zx90316/Flip-Clock/cad/r2/README.md

# FC-R2 桌面翻頁鐘原型

狀態：本輪模擬定位通過，仍為 CAD／剛體接觸原型。顯示可讀性、逐片翻轉、列印配合、馬達、彈簧與長時間運轉尚待驗證。

本輪交付：[校準結果與限制](RESULTS.md)、[STEP／STL 原型包](package/FC-R2-desktop-prototype.zip)、[正面物理回放](review_native/front.mp4)、[機構剖視](review_native/cutaway.mp4)。本輪修正實體棘爪止擋，改用原生碰撞演算法，並提高小時輪的被動阻力；驗收以逐步紀錄及時間步長比較為準。舊版未通過的運算保留在 `review/`。

[本機 3D 檢視與逐件目錄](VIEWER.md) 提供裝配、機構、試片與 141 個列印件的連結，可自行開啟查看。

## 桌面尺寸與外觀

外形 190 × 175.4 × 120 mm（深度包含前框），底板 190 × 174 mm。相較 R1 的 312 × 280 mm 底板，占桌面積減少約 62%。暖白圓角外殼、深色前板、雙視窗與白色冒號；前板從內側固定，傳動與調時旋鈕收在殼內。

外殼分成底板、倒置列印的罩殼、平放列印的前後板與前框。後蓋可拆，方便調整與校準。STEP 的扇形翻片是檢查姿態；實際重力姿態以模擬回放為準。

## 單馬達機構

- 分鐘 60 片，每格 6°；小時 24 片，每格 15°。
- 一顆馬達、兩組方向相反的實體棘爪；負向輸入驅動分鐘，正向輸入驅動小時。兩個輸出都向展示面下翻。
- 棘爪增加連通的尾端止擋面，載體使用避開樞軸的實體止擋；原生輪廓掃描在接合側約 3.5° 開始接觸，空轉側檢查至 35° 無干涉。這不是以關節角度限制代替接觸。
- 分鐘齒輪 40→20→40；小時 60→20→20→40。小時輸出速度為輸入的 1.5 倍，方向相反。
- 分鐘樞軸半徑 36.5 mm；小時 14.9 mm，小時軸向前移 21.6 mm。兩輪正面樞軸同在 Y=36.5 mm，相鄰下半頁的樞軸高度差約 0.04 mm。
- 每輪獨立定位凸輪、彈簧壓輪與最終輸出角度回授位置。
- 馬達經 1:1 皮帶傳到共用輸入軸。皮帶彈性、跳齒與齒輪箱內部間隙尚未模擬；馬達是有限扭矩等效模型。

50 mN·m 是模擬用輸入扭矩預算，不是已確認的 28BYJ-48 規格。實際馬達與驅動器尚待選型，不能直接把模擬扭矩命令當成現有韌體。

## FDM 設計

依使用者指定的 Bambu X2D、0.4 mm 噴嘴、0.2 mm 層高、256 × 256 mm 成形面設計。所有列印件在指定方向的 XY 尺寸均落在此範圍；未輸出機台 G-code。

翻片採 1.2 mm 完整薄片，等於六層 0.2 mm。實心轉軸保留 Ø2.2 mm 最大迴轉包絡，前緣削平到與片面共面，正面貼床；這能保留薄片間隙，又不讓大片片體懸空。軸孔名義 Ø2.6 mm，另附 Ø2.4／2.5／2.6／2.7 mm 試片供 PLA、PETG 各自調配。

字樣為自繪七段向量，採雙面轉印或模板上色，STL 沒有凸字與凹槽。這保留完整 1.2 mm 片厚。先用 M08、M09 試片確認正反面方向，再處理全部 84 片。[轉印稿](graphics/README.md)

機構受力件與翻片先按實心列印，以便對照模擬質量；外殼可依標準材料設定使用較低填充。建議先試 PETG 活動件與 PLA 外殼，兩種材料都要重新量測配合。切片時保留原有外形比例，不要整組縮放補孔。

罩殼外頂面貼床、側壁向上生長；前後板平放；齒輪、棘爪、凸輪與側架以寬面貼床。部分軸筒上肩、底部孔口與內側固定耳需要局部支撐／橋接驗證，外觀表面不應接觸支撐。擋線定位孔需鑽修至 Ø1.1 mm。完整量測見 [FDM 報告](reports/dfam/summary.json)，不能把壁厚通過解讀為已完成切片與列印驗證。

## 檢視與重建

- `STEP/assembly.step`：包覆外殼的檢查姿態。
- `STEP/assembly_with_drag.step`：加入兩個非列印毛氈阻力環的候選裝配；其餘列印件相同。
- `STEP/mechanism.step`：機構檢查姿態。
- `STL/coupons.stl`：薄片、轉軸孔與 Ø8 mm 軸孔試片。
- `STL/parts/`：按指定方向落床的零件。以 `reports/parts.json` 為有效清單，目錄中其他舊輸出不屬於交付。
- `review_native/`：本輪選定的原生碰撞求解紀錄、影片、逐步驗收與來源雜湊。
- `review/`：保留的舊版失敗紀錄；原始試驗在忽略版控的 `runs/`。

從專案根目錄執行 `cad/r2/build.ps1 -Fdm -Physics`。需要已安裝 text-to-cad 0.7.17 與 uv；套件版本記錄在 `reports/dependencies.lock.json`。此流程不開啟桌面視窗，也不連線列印機。

原型 ZIP 保留 `Flip-Clock/cad/r2` 與所需共用函式的目錄結構；解壓後在 `Flip-Clock` 執行同一指令。DfAM 工具預設從使用者的 text-to-cad 0.7.17 安裝尋找，若位置不同可用 `DFAM_SKILL_DIR` 指向 `dfam-check` 資料夾。影片與完整碰撞求解資產另存 GitHub 的 `review_native/`，沒有塞入列印原型 ZIP。

## 分／時輪阻力候選

本輪候選為分鐘 5 mN·m、小時 20 mN·m 的庫侖阻力，設定見 [drag_candidate.json](config/drag_candidate.json)。舊版的 15 mN·m 小時阻力在原生碰撞計算下雖能連續到位，閒置瞬間偏移仍曾超過 0.25°，因此提高小時輪阻力重測。這是力等效參數整定，尚未量到真實材料的阻力。

候選機構在既有軸承外側與調時旋鈕間，加入外徑 20 mm、內徑 16.2 mm、安裝厚度 1.1 mm 的非列印毛氈環。名義尺寸在 STEP 中無實體重疊；不能據此推定預壓、磨耗與阻力已成立。以旋鈕半徑 13 mm 量測時，先抬起定位壓輪，分鐘／小時的切向阻力目標分別約 0.385／1.538 N。實際環厚與預壓需依量測調整。

這兩個環在目前剛體模型中只由 `dof_frictionloss` 作力等效，沒有解析毛氈壓縮接觸。單獨開啟 XML 不會自動套用候選值；完整參數在 `review_native/run_config.json`，重建指令會套用設定檔。

本輪另以 [原生碰撞與摩擦求解設定](config/native_friction_trial.json) 降低靜止摩擦的數值滑動：接觸時間常數仍為 0.0006 s，關節摩擦時間常數改為 0.0002 s、阻抗 0.999。這些是求解器的正則化設定，不是 PETG 彈性或毛氈的實測材料數據。`build.ps1 -Physics` 會套用此檔並檢查每個步進；兩種時間步長及額外連續測試的固定證據保存在 `review_native/`。

## 模擬證據的範圍

MuJoCo 3.17.0、真實重力、由原生 CAD 輪廓生成的凸分塊碰撞、84 個獨立翻片鉸鏈。只有輸入軸施加有限扭矩；沒有理想齒輪關係、單向關節或指定輸出角度。定位彈簧與軸阻力使用明列的力等效假設。

從初始翻片與齒隙狀態起，每一次指令都納入驗收，包含第一循環。目標沿名義刻度前進，失步後不把目標改設到錯誤的實際位置。閒置輪檢查每個積分步的瞬間偏移，並以最後一次命令刻度為基準；另檢查停靠最後 0.25 秒的振幅與速度。`COMPLETED` 僅表示運算結束，驗收以 `validation.json` 及時間步長比較為準。

底座固定於世界座標，未測整機滑移或傾倒。質量來自完整 CAD 體積與提案密度，尚未秤重；齒輪與軸的同體連接假設剛性傳力，實物固定方式與配合仍需驗證。沒有模擬薄片彎曲、列印層間強度、孔磨耗、感測器誤差與電子延遲。可視網格保留完整外形；碰撞中填平非工作減重孔、字樣與部分固定孔，軸承與軸銷內部用鉸鏈等效。實機、壽命與製造就緒旗標均維持 false。

## 來源

本輪由專案自建的 R1 基礎函式重新參數化，未把原作者 ZIP 或其網格作為幾何輸入。字形與外殼均為新建。標準軸承使用名義包絡；STEP 零件庫查詢紀錄在 `reports/catalog_search.json`，馬達與皮帶尚未完成採購尺寸確認。

FDM 限值依 text-to-cad 0.7.17 的 dfam-check 預設（支撐壁厚 1.2 mm、懸空壁厚 1.6 mm、45° 支撐角）比較。列印方向與配合仍應以機台試片校準；可參考 [Prusa 的列印設計說明](https://help.prusa3d.com/article/modeling-with-3d-printing-in-mind_164135)。彈簧力率提案使用圓線螺旋彈簧關係式，並非實測，公式可對照 [Maruho Spring 設計資料](https://www.maruho-htj.co.jp/en/mnet/design/compression/)。
