zx90316/Flip-Clock/cad/r2/graphics/README.md

# FC-R2 雙面字樣轉印稿

四張 A4 SVG、100% 尺寸；每格 34 × 18 mm。H00–H23、M00–M59。

正面是本片的上半字，背面是下一片號碼的下半字。背面圖樣配合繞 X 軸翻轉，刻意鏡像；請依檔案直接製作，不要再次鏡像。正反面分開轉印／遮罩上色；本稿未宣稱印表機雙面套準。先用 M08 與 M09 兩片確認翻轉後讀值，再處理整組。

字樣為本專案自繪七段向量，不使用原作者圖樣或外部字型。這是上色／轉印圖樣，STL 保持完整 1.2 mm 薄片，不含凸字或刻槽。不同塗層厚度與磨擦必須實際驗證。
