zx90316/Flip-Clock/cad/source/original/README.md

# 原作者資料（本機封存）

本資料夾保存使用者提供的 `Flip+Clock+Mechanism.zip` 及解開的模型。
原檔不修改、不執行，也不納入 Git 或公開發布。來源為 MakerWorld 908946，
作者 NotKuro。來源授權目前依使用者規格書記載為 Standard Digital File License；
本機 ZIP 沒有提供完整授權文字，不能據此授權再散布。

接收、檔案清單及 SHA-256 見 `../../reports/original_manifest.json`。
網格座標量測不代表實物配合已驗證；缺少組裝 PDF／原生 CAD 的項目保留待確認。
