zx90316/Flip-Clock/cad/DESIGN.md

# FC-R1 設計依據與組裝

設計決策 2026-11-04：依使用者「完整重新設計」指示，取代 908946 轉接／沿用方案。
本設計自行選定尺寸、輪廓與裝配方式。先前已讀取原 ZIP 清單、網格包圍盒和部分縮圖；
切換後的建模來源不引用該資料。不聲稱未接觸過原檔。

## 功能與座標

[R] 一顆馬達、無換檔致動器；以輸入正反轉選擇兩組相反接合的超越式棘輪。
時輪 24 片 00–23，分輪 60 片 00–59；兩輪各有定位、手動順向校時與最終輸出感測。

X 沿平行轉軸，Y 向顯示正面，Z 向上。所有轉角依同一 +X 右手法則。
共同輸入 I 在 Y=-108 mm，鼓軸在 Y=0，兩者 Z=88 mm。
時／分鼓中心 X=+42／-42 mm；齒輪工作平面 X=+76／-76 mm。
從 +Y 看向時鐘正面時，+X 在畫面左側，因此時輪在左、分輪在右；字形亦按此方向配置。
這些尺寸全部是 [P] 新設計起點，不是原機量測或列印配合保證。

分支兩次外嚙合：(+I) → (+OM) → (−idler) → (+M)，40:20:40，rM=1。
時支一次外嚙合：(−I) → (−OH) → (+H)，60:60，rH=1。
M+ 或 H+ 手動超越的可行性須由實體棘爪、摩擦與定位接觸驗證；方向表不代替動態。
36 齒棘輪的單齒距為 10°，不是分輪 6° 的補步常數，因此必須使用最終輸出回授。

## 原創幾何

- 外齒輪由標準漸開線方程求得齒側，24 點樣條、實圓齒頂、實圓齒根及 0.25m 原生圓角。
- 內棘輪採圓整驅動面／越齒斜面，24／36／48 齒均有完整工作輪廓。
- 棘爪獨立樞轉，載體有實體止擋；金屬彈簧負責回位，不能用彈簧代替驅動面承載。
- 鼓盤為 51 mm 外半徑、48 mm 片軸半徑；內框、輪轂、減重孔、孔位完全另建。
- 翻片寬 48、長 26、厚 0.95 mm；鉸鏈桶外徑 4 mm、孔徑 2.3 mm，搭配 2 mm 銷。
- 數字不用作者字形、圖片或外部字型，使用專案自行定義的七段幾何。
- 每片 k 的上半為 k，下半背面為 (k+1) mod N；實際正面配對仍須落片驗證。
- 編號 k 的片軸方位為 −k×格距，確保輸出依 +X 正轉時，下一個編號會接近固定釋放方位。

## 支承與自由度

I 由兩端 608ZZ 支承，兩個棘爪載體固定在 I 上。每個輸出環有自己的滑動軸套，
不固定到框架，也不與另一輸出環夾死。OM、OH 相對 I 各保留旋轉自由度。
各棘爪有獨立銷及止擋；翻片各有獨立銷。

時、分鼓使用兩支獨立 Ø8 mm 軸，X 範圍分別 [4,116]、[-116,-4] mm，端部間隙 8 mm。
中央支架有兩個分離軸承座；外側各一個座。沒有共用剛性輸出軸。
分支惰輪以固定銷與獨立軸套支承在側架，齒輪不是懸浮示意件。
定位盤及旋鈕均在最終輸出軸上，位於離合器和傳動之後。
齒輪平面在 |X|=76 mm、定位盤在 |X|=87 mm，手動旋鈕在外框之外的 |X|=108 mm。
定位滾輪臂與彈簧設於齒輪外側；支架腳位及螺絲通道避免與側架底座交疊。
定位槽頂／底均有 0.4 mm 原生圓角。滾輪安裝位置依完整槽邊輪廓求最短距離，
幾何檢查姿態另留約 0.02 mm 間隙；不將此位置當成彈簧預壓下的動態平衡解。

## 起始製程與配合

[P] 框架、齒輪及鼓盤先以 PETG／PLA 試片比較；棘爪、鉸鏈與長期受力支架優先 PETG。
不提供虛構的材料強度或彈簧剛度。質量資料使用實心 CAD 估算，正式版本需秤重修正。

[P] 0.2 mm 層高、0.4 mm 噴嘴、4 壁、齒輪／棘爪 100% 填充起測；
配合階梯涵蓋 8 mm 軸單邊 0.15／0.20／0.25／0.30 mm 間隙。
齒輪與鼓盤平放，片體大面平放；片軸孔須清孔／鉸孔，不能把支撐殘痕當軸承面。
0.95 mm 翻片、0.85 mm 鉸鏈孔壁、棘爪齒根均需試印與受力驗證。

新支架為寬鬆台架尺寸，底板 312×280×6 mm，分成四塊，最大 168×140 mm。
接縫以四片上方連接板及 M3 螺絲固定；底部 TPU 腳墊提供 2 mm 空間。
實際成形面仍須逐件核對 STL 目錄的包圍盒，不把模型有效直接當成可量產證據。

## 建議裝入順序

1. 先印配合階梯、單離合器與鉸鏈試片，量測阻力與孔徑。
2. 從底板下側裝 M3 螺帽，上側裝側架、中央雙軸承座、馬達座與感測座；螺絲自上方進入。
3. 將六個 608ZZ 軸承裝入支架。中央兩座分開，確認軸承內圈不被端面夾緊。
4. 先在輸入軸套上兩組滑動軸套、輸出環、載體、棘爪銷與金屬彈簧，再穿入輸入軸。
5. 裝分支惰輪銷與軸套，確認工作平面及齒側間隙，再裝兩個最終輸出齒輪。
6. 分別裝鼓輪轂、左右鼓盤與 60／24 片翻片，穿銷，最後鎖固鼓盤及輪轂。
7. 裝兩支獨立輸出軸、定位盤、滾輪臂及預壓件，確認手動一圈不夾死。
8. 裝手動旋鈕、磁鐵帽、感測模組；釋放指先保持退開，再由單輪試驗逐步調整。
9. 完成感測零位校準、接觸／負載試驗後才裝護板，最後進行帶負載動作。

這是待實物確認的裝入順序。螺絲頭、工具通道、緊固長度、彈簧端部固定及軸承軸向擋件
仍須在製造凍結前逐項確認，不以裝配文字取代可拆裝驗收。

## 尚待取得的證據

- 棘爪的接觸相位、彈簧固定／預壓與自鎖／抬爪測試；金屬彈簧幾何不是剛度校準。
- 定位保持、手轉、馬達驅動同時成立的扭矩窗口，以及斷電回彈是否擾動另一輪。
- 翻片在重力下的堆疊、支承、單片釋放、落片及安全顯示角窗。
- 24／60 個位置的真實上下半頁配對與 23→00、59→00。
- 有限扭矩、摩擦、反轉背隙及完整接觸運轉的收斂／實測校準；已建立 MuJoCo 探索性檢視，見 PHYSICS_VIEW.md。
- 精確馬達軸扁位、編碼器模組／磁鐵規格、感測誤差與電氣接線。
- 靜強度、層間破壞、蠕變、磨耗與實機耐久；正式 BOM 的緊固件及擋圈完整選型。

正式製造包由驗證閘門封鎖。現有 ESP 韌體未修改，不當作新雙輸出閉迴路控制器。
