zx90316/Flip-Clock/tools/requirements-windows.lock.txt

bleak==3.0.1
winrt-runtime==4.0.3
winrt-Windows.Devices.Bluetooth==4!10.0.28000.2705
winrt-Windows.Devices.Bluetooth.Advertisement==4!10.0.28000.2705
winrt-Windows.Devices.Bluetooth.GenericAttributeProfile==4!10.0.28000.2705
winrt-Windows.Devices.Enumeration==4!10.0.28000.2705
winrt-Windows.Devices.Radios==4!10.0.28000.2705
winrt-Windows.Foundation==4!10.0.28000.2705
winrt-Windows.Foundation.Collections==4!10.0.28000.2705
winrt-Windows.Storage.Streams==4!10.0.28000.2705
typing_extensions==4.16.0
