zx90316/Flip-Clock/cad/reports/delivery.md

# FC-R1 交付狀態

全新參數化 CAD 初版，concept_only。

- 指定幾何檢查：60/60 PASS。
- 工程原型分件：135 種，網格檢查 PASS。
- 時輪 24 片、分輪 60 片；兩支獨立輸出軸；單共同輸入。
- 原作者網格、原尺寸及封存原檔不屬建模輸入或交付包。
- 已完成 1.6 秒 MuJoCo 3.17.0 探索性運算；GitHub 回放、影片及資料見 ../PHYSICS_VIEW.md。
- 反向輸入時分鼓仍前進約 20.5°；釋放指退回，尚未完成定位保持與單片放行。
- 互動視窗的桌面操作留待使用者自行確認。
- 物理、馬達、硬體、耐久及完整連續碰撞均未通過驗收。

見 verification.json 與 DESIGN.md；不得將 CAD 檢查當成完成實機證據。
