zx90316/Flip-Clock/docs/hardware-acceptance.csv

id | test | status | firmware_sha256 | date | board_motor | parameters | voltage_current_temperature | observed_result | evidence | operator
H01 | LM2596 輸出 5.0V 及接線 | 未執行
H02 | 30 次冷啟動：可開機且無意外連續轉動 | 未執行
H03 | 開機時 IO12-15 造成的馬達抖動與步數誤差 | 未執行
H04 | 半步相序及輸出關閉 | 未執行
H05 | 900 步/秒、400 步/秒² 帶負載不漏步 | 未執行
H06 | Wi-Fi/網頁/掃描進行中走時平順 | 未執行
H07 | Wi-Fi＋馬達動作時電壓及溫升 | 未執行
H08 | stop <=100ms / pause 當段完成 | 未執行
H09 | 不同工作階段及 NVS 寫入時掉電 | 未執行
H10 | 斷電重啟後取得網路時間並補跑 | 未執行
H11 | 24 小時斷網恢復 | 未執行
H12 | 完整週期及 72 小時走時 | 未執行
H13 | 網頁登入、改密碼、OTA 斷網/斷電 | 未執行
H14 | Android/iOS 配對及未授權拒絕 | 未執行
H15 | BLE 重送/斷線/最低 MTU | 未執行
