zx90316/Flip-Clock/cad/r2/review_native/README.md

# FC-R2 物理回放

這是求解器記錄的重力、碰撞與單一有限輸入扭矩運算。`COMPLETED` 只代表運算完成，定位驗收以 `acceptance.json` 為準；此包未宣稱實機或製造就緒。

- `desktop.mp4`：包覆式外觀。
- `front.mp4`：前方翻片與轉角。
- `cutaway.mp4`：隱藏外殼，紅點為抽樣的實際接觸位置。
- `states.npz`、`trajectory.csv`：求解器角度、速度與輸入扭矩。
- `model/`：相同版本 MuJoCo 可開啟的 XML 與碰撞／可視資產。
- `source/`：執行時來源快照；不是另一套維護中的 CAD 主檔。

影片由已記錄狀態慢放，沒有補造翻片姿態。完整參數、假設與輸出輪未通過項保留於 JSON。輸出輪無致動器，無理想齒輪／單向等式；彈簧與軸阻力為明列但未實測的力等效模型。

XML 是幾何與基準力學模型。重播或重跑時必須一併套用 `run_config.json` 的時間步長、重力、摩擦、分／時輪阻力與輸入扭矩限制；單獨開啟 XML 不會自動套用本輪整定。`simulation/render_r2.py` 已在回放前還原這些參數。影片以 60 Hz 紀錄、30 fps 慢放；接觸點為抽樣資料，全步長最大穿透以 `summary.json` 為準。

每個指令步進的角度、閒置輪瞬間偏移與最後停靠範圍見 `validation.json`；時間步長比較見 `timestep_comparison.json`。對照資料在 `comparison/`；若該運算的 XML 不同，另附其完整 `model/`。`acceptance.json` 的 `extended_scenarios` 列出額外納入驗收的連續分鐘／小時試驗，必須使用相同候選設定且各自通過。其餘對照可以是保留的失敗診斷，不能混作驗收。驗收門檻與結論均以 `acceptance.json` 為準。
