zx90316/Flip-Clock/cad/r2/VIEWER.md

# FC-R2 本機 3D 檢視

以下連結使用本輪已確認的本機 CAD Viewer；由你自行點選，不會自動開啟或控制桌面。STEP 為裝配檢查姿態，重力與碰撞運動請看物理回放。移動專案資料夾後需依新位置更新連結。

- [含阻力環的候選裝配](http://127.0.0.1:3245/?file=D%3A%2FProject%2FFlip-Clock%2Fcad%2Fr2%2FSTEP%2Fassembly_with_drag.step)
- [包覆外殼的基準裝配](http://127.0.0.1:3245/?file=D%3A%2FProject%2FFlip-Clock%2Fcad%2Fr2%2FSTEP%2Fassembly.step)
- [內部機構](http://127.0.0.1:3245/?file=D%3A%2FProject%2FFlip-Clock%2Fcad%2Fr2%2FSTEP%2Fmechanism.step)
- [薄片與配合試片](http://127.0.0.1:3245/?file=D%3A%2FProject%2FFlip-Clock%2Fcad%2Fr2%2FSTEP%2Fcoupons.step)
- [非列印阻力環](http://127.0.0.1:3245/?file=D%3A%2FProject%2FFlip-Clock%2Fcad%2Fr2%2FSTEP%2Fdrag_rings.step)

## 個別列印件

- [A00_single_base](http://127.0.0.1:3245/?file=D%3A%2FProject%2FFlip-Clock%2Fcad%2Fr2%2FSTEP%2Fparts%2FA00_single_base.step)
- [A10_M_internal_frame](http://127.0.0.1:3245/?file=D%3A%2FProject%2FFlip-Clock%2Fcad%2Fr2%2FSTEP%2Fparts%2FA10_M_internal_frame.step)
- [A10_H_internal_frame](http://127.0.0.1:3245/?file=D%3A%2FProject%2FFlip-Clock%2Fcad%2Fr2%2FSTEP%2Fparts%2FA10_H_internal_frame.step)
- [A11_center_plain_bearing_pedestal](http://127.0.0.1:3245/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)
- [TM_output_gear](http://127.0.0.1:3245/?file=D%3A%2FProject%2FFlip-Clock%2Fcad%2Fr2%2FSTEP%2Fparts%2FTM_output_gear.step)
- [TH_output_gear](http://127.0.0.1:3245/?file=D%3A%2FProject%2FFlip-Clock%2Fcad%2Fr2%2FSTEP%2Fparts%2FTH_output_gear.step)
- [T_idler](http://127.0.0.1:3245/?file=D%3A%2FProject%2FFlip-Clock%2Fcad%2Fr2%2FSTEP%2Fparts%2FT_idler.step)
- [T_idler_pedestal](http://127.0.0.1:3245/?file=D%3A%2FProject%2FFlip-Clock%2Fcad%2Fr2%2FSTEP%2Fparts%2FT_idler_pedestal.step)
- [TH_idler_0](http://127.0.0.1:3245/?file=D%3A%2FProject%2FFlip-Clock%2Fcad%2Fr2%2FSTEP%2Fparts%2FTH_idler_0.step)
- [TH_idler_1](http://127.0.0.1:3245/?file=D%3A%2FProject%2FFlip-Clock%2Fcad%2Fr2%2FSTEP%2Fparts%2FTH_idler_1.step)
- [TH_idler_bridge](http://127.0.0.1:3245/?file=D%3A%2FProject%2FFlip-Clock%2Fcad%2Fr2%2FSTEP%2Fparts%2FTH_idler_bridge.step)
- [E_slotted_motor_saddle](http://127.0.0.1:3245/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)
- [E_motor_top_clamp](http://127.0.0.1:3245/?file=D%3A%2FProject%2FFlip-Clock%2Fcad%2Fr2%2FSTEP%2Fparts%2FE_motor_top_clamp.step)
- [BM_center_bush](http://127.0.0.1:3245/?file=D%3A%2FProject%2FFlip-Clock%2Fcad%2Fr2%2FSTEP%2Fparts%2FBM_center_bush.step)
- [BH_center_bush](http://127.0.0.1:3245/?file=D%3A%2FProject%2FFlip-Clock%2Fcad%2Fr2%2FSTEP%2Fparts%2FBH_center_bush.step)
- [CM_output](http://127.0.0.1:3245/?file=D%3A%2FProject%2FFlip-Clock%2Fcad%2Fr2%2FSTEP%2Fparts%2FCM_output.step)
- [CM_backplate](http://127.0.0.1:3245/?file=D%3A%2FProject%2FFlip-Clock%2Fcad%2Fr2%2FSTEP%2Fparts%2FCM_backplate.step)
- [CM_carrier](http://127.0.0.1:3245/?file=D%3A%2FProject%2FFlip-Clock%2Fcad%2Fr2%2FSTEP%2Fparts%2FCM_carrier.step)
- [CM_pawl](http://127.0.0.1:3245/?file=D%3A%2FProject%2FFlip-Clock%2Fcad%2Fr2%2FSTEP%2Fparts%2FCM_pawl.step)
- [CM_cover](http://127.0.0.1:3245/?file=D%3A%2FProject%2FFlip-Clock%2Fcad%2Fr2%2FSTEP%2Fparts%2FCM_cover.step)
- [CM_bushing](http://127.0.0.1:3245/?file=D%3A%2FProject%2FFlip-Clock%2Fcad%2Fr2%2FSTEP%2Fparts%2FCM_bushing.step)
- [CM_post_0](http://127.0.0.1:3245/?file=D%3A%2FProject%2FFlip-Clock%2Fcad%2Fr2%2FSTEP%2Fparts%2FCM_post_0.step)
- [CM_post_1](http://127.0.0.1:3245/?file=D%3A%2FProject%2FFlip-Clock%2Fcad%2Fr2%2FSTEP%2Fparts%2FCM_post_1.step)
- [CM_post_2](http://127.0.0.1:3245/?file=D%3A%2FProject%2FFlip-Clock%2Fcad%2Fr2%2FSTEP%2Fparts%2FCM_post_2.step)
- [CH_output](http://127.0.0.1:3245/?file=D%3A%2FProject%2FFlip-Clock%2Fcad%2Fr2%2FSTEP%2Fparts%2FCH_output.step)
- [CH_backplate](http://127.0.0.1:3245/?file=D%3A%2FProject%2FFlip-Clock%2Fcad%2Fr2%2FSTEP%2Fparts%2FCH_backplate.step)
- [CH_carrier](http://127.0.0.1:3245/?file=D%3A%2FProject%2FFlip-Clock%2Fcad%2Fr2%2FSTEP%2Fparts%2FCH_carrier.step)
- [CH_pawl](http://127.0.0.1:3245/?file=D%3A%2FProject%2FFlip-Clock%2Fcad%2Fr2%2FSTEP%2Fparts%2FCH_pawl.step)
- [CH_cover](http://127.0.0.1:3245/?file=D%3A%2FProject%2FFlip-Clock%2Fcad%2Fr2%2FSTEP%2Fparts%2FCH_cover.step)
- [CH_bushing](http://127.0.0.1:3245/?file=D%3A%2FProject%2FFlip-Clock%2Fcad%2Fr2%2FSTEP%2Fparts%2FCH_bushing.step)
- [CH_post_0](http://127.0.0.1:3245/?file=D%3A%2FProject%2FFlip-Clock%2Fcad%2Fr2%2FSTEP%2Fparts%2FCH_post_0.step)
- [CH_post_1](http://127.0.0.1:3245/?file=D%3A%2FProject%2FFlip-Clock%2Fcad%2Fr2%2FSTEP%2Fparts%2FCH_post_1.step)
- [CH_post_2](http://127.0.0.1:3245/?file=D%3A%2FProject%2FFlip-Clock%2Fcad%2Fr2%2FSTEP%2Fparts%2FCH_post_2.step)
- [DM_core](http://127.0.0.1:3245/?file=D%3A%2FProject%2FFlip-Clock%2Fcad%2Fr2%2FSTEP%2Fparts%2FDM_core.step)
- [DM_flange_-1](http://127.0.0.1:3245/?file=D%3A%2FProject%2FFlip-Clock%2Fcad%2Fr2%2FSTEP%2Fparts%2FDM_flange_-1.step)
- [DM_flange_1](http://127.0.0.1:3245/?file=D%3A%2FProject%2FFlip-Clock%2Fcad%2Fr2%2FSTEP%2Fparts%2FDM_flange_1.step)
- [FM_00_panel](http://127.0.0.1:3245/?file=D%3A%2FProject%2FFlip-Clock%2Fcad%2Fr2%2FSTEP%2Fparts%2FFM_00_panel.step)
- [FM_01_panel](http://127.0.0.1:3245/?file=D%3A%2FProject%2FFlip-Clock%2Fcad%2Fr2%2FSTEP%2Fparts%2FFM_01_panel.step)
- [FM_02_panel](http://127.0.0.1:3245/?file=D%3A%2FProject%2FFlip-Clock%2Fcad%2Fr2%2FSTEP%2Fparts%2FFM_02_panel.step)
- [FM_03_panel](http://127.0.0.1:3245/?file=D%3A%2FProject%2FFlip-Clock%2Fcad%2Fr2%2FSTEP%2Fparts%2FFM_03_panel.step)
- [FM_04_panel](http://127.0.0.1:3245/?file=D%3A%2FProject%2FFlip-Clock%2Fcad%2Fr2%2FSTEP%2Fparts%2FFM_04_panel.step)
- [FM_05_panel](http://127.0.0.1:3245/?file=D%3A%2FProject%2FFlip-Clock%2Fcad%2Fr2%2FSTEP%2Fparts%2FFM_05_panel.step)
- [FM_06_panel](http://127.0.0.1:3245/?file=D%3A%2FProject%2FFlip-Clock%2Fcad%2Fr2%2FSTEP%2Fparts%2FFM_06_panel.step)
- [FM_07_panel](http://127.0.0.1:3245/?file=D%3A%2FProject%2FFlip-Clock%2Fcad%2Fr2%2FSTEP%2Fparts%2FFM_07_panel.step)
- [FM_08_panel](http://127.0.0.1:3245/?file=D%3A%2FProject%2FFlip-Clock%2Fcad%2Fr2%2FSTEP%2Fparts%2FFM_08_panel.step)
- [FM_09_panel](http://127.0.0.1:3245/?file=D%3A%2FProject%2FFlip-Clock%2Fcad%2Fr2%2FSTEP%2Fparts%2FFM_09_panel.step)
- [FM_10_panel](http://127.0.0.1:3245/?file=D%3A%2FProject%2FFlip-Clock%2Fcad%2Fr2%2FSTEP%2Fparts%2FFM_10_panel.step)
- [FM_11_panel](http://127.0.0.1:3245/?file=D%3A%2FProject%2FFlip-Clock%2Fcad%2Fr2%2FSTEP%2Fparts%2FFM_11_panel.step)
- [FM_12_panel](http://127.0.0.1:3245/?file=D%3A%2FProject%2FFlip-Clock%2Fcad%2Fr2%2FSTEP%2Fparts%2FFM_12_panel.step)
- [FM_13_panel](http://127.0.0.1:3245/?file=D%3A%2FProject%2FFlip-Clock%2Fcad%2Fr2%2FSTEP%2Fparts%2FFM_13_panel.step)
- [FM_14_panel](http://127.0.0.1:3245/?file=D%3A%2FProject%2FFlip-Clock%2Fcad%2Fr2%2FSTEP%2Fparts%2FFM_14_panel.step)
- [FM_15_panel](http://127.0.0.1:3245/?file=D%3A%2FProject%2FFlip-Clock%2Fcad%2Fr2%2FSTEP%2Fparts%2FFM_15_panel.step)
- [FM_16_panel](http://127.0.0.1:3245/?file=D%3A%2FProject%2FFlip-Clock%2Fcad%2Fr2%2FSTEP%2Fparts%2FFM_16_panel.step)
- [FM_17_panel](http://127.0.0.1:3245/?file=D%3A%2FProject%2FFlip-Clock%2Fcad%2Fr2%2FSTEP%2Fparts%2FFM_17_panel.step)
- [FM_18_panel](http://127.0.0.1:3245/?file=D%3A%2FProject%2FFlip-Clock%2Fcad%2Fr2%2FSTEP%2Fparts%2FFM_18_panel.step)
- [FM_19_panel](http://127.0.0.1:3245/?file=D%3A%2FProject%2FFlip-Clock%2Fcad%2Fr2%2FSTEP%2Fparts%2FFM_19_panel.step)
- [FM_20_panel](http://127.0.0.1:3245/?file=D%3A%2FProject%2FFlip-Clock%2Fcad%2Fr2%2FSTEP%2Fparts%2FFM_20_panel.step)
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
- [FH_19_panel](http://127.0.0.1:3245/?file=D%3A%2FProject%2FFlip-Clock%2Fcad%2Fr2%2FSTEP%2Fparts%2FFH_19_panel.step)
- [FH_20_panel](http://127.0.0.1:3245/?file=D%3A%2FProject%2FFlip-Clock%2Fcad%2Fr2%2FSTEP%2Fparts%2FFH_20_panel.step)
- [FH_21_panel](http://127.0.0.1:3245/?file=D%3A%2FProject%2FFlip-Clock%2Fcad%2Fr2%2FSTEP%2Fparts%2FFH_21_panel.step)
- [FH_22_panel](http://127.0.0.1:3245/?file=D%3A%2FProject%2FFlip-Clock%2Fcad%2Fr2%2FSTEP%2Fparts%2FFH_22_panel.step)
- [FH_23_panel](http://127.0.0.1:3245/?file=D%3A%2FProject%2FFlip-Clock%2Fcad%2Fr2%2FSTEP%2Fparts%2FFH_23_panel.step)
- [DEM_cam](http://127.0.0.1:3245/?file=D%3A%2FProject%2FFlip-Clock%2Fcad%2Fr2%2FSTEP%2Fparts%2FDEM_cam.step)
- [DEM_arm](http://127.0.0.1:3245/?file=D%3A%2FProject%2FFlip-Clock%2Fcad%2Fr2%2FSTEP%2Fparts%2FDEM_arm.step)
- [DEM_bracket](http://127.0.0.1:3245/?file=D%3A%2FProject%2FFlip-Clock%2Fcad%2Fr2%2FSTEP%2Fparts%2FDEM_bracket.step)
- [KM_service_knob](http://127.0.0.1:3245/?file=D%3A%2FProject%2FFlip-Clock%2Fcad%2Fr2%2FSTEP%2Fparts%2FKM_service_knob.step)
- [DEH_cam](http://127.0.0.1:3245/?file=D%3A%2FProject%2FFlip-Clock%2Fcad%2Fr2%2FSTEP%2Fparts%2FDEH_cam.step)
- [DEH_arm](http://127.0.0.1:3245/?file=D%3A%2FProject%2FFlip-Clock%2Fcad%2Fr2%2FSTEP%2Fparts%2FDEH_arm.step)
- [DEH_bracket](http://127.0.0.1:3245/?file=D%3A%2FProject%2FFlip-Clock%2Fcad%2Fr2%2FSTEP%2Fparts%2FDEH_bracket.step)
- [KH_service_knob](http://127.0.0.1:3245/?file=D%3A%2FProject%2FFlip-Clock%2Fcad%2Fr2%2FSTEP%2Fparts%2FKH_service_knob.step)
- [SM_encoder_holder](http://127.0.0.1:3245/?file=D%3A%2FProject%2FFlip-Clock%2Fcad%2Fr2%2FSTEP%2Fparts%2FSM_encoder_holder.step)
- [SM_magnet_cap](http://127.0.0.1:3245/?file=D%3A%2FProject%2FFlip-Clock%2Fcad%2Fr2%2FSTEP%2Fparts%2FSM_magnet_cap.step)
- [SH_encoder_holder](http://127.0.0.1:3245/?file=D%3A%2FProject%2FFlip-Clock%2Fcad%2Fr2%2FSTEP%2Fparts%2FSH_encoder_holder.step)
- [SH_magnet_cap](http://127.0.0.1:3245/?file=D%3A%2FProject%2FFlip-Clock%2Fcad%2Fr2%2FSTEP%2Fparts%2FSH_magnet_cap.step)
- [A01_inverted_print_hood](http://127.0.0.1:3245/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)
- [A02_front_panel](http://127.0.0.1:3245/?file=D%3A%2FProject%2FFlip-Clock%2Fcad%2Fr2%2FSTEP%2Fparts%2FA02_front_panel.step)
- [A03_rear_panel](http://127.0.0.1:3245/?file=D%3A%2FProject%2FFlip-Clock%2Fcad%2Fr2%2FSTEP%2Fparts%2FA03_rear_panel.step)
- [A04_display_bezel](http://127.0.0.1:3245/?file=D%3A%2FProject%2FFlip-Clock%2Fcad%2Fr2%2FSTEP%2Fparts%2FA04_display_bezel.step)
- [A05_colon_0](http://127.0.0.1:3245/?file=D%3A%2FProject%2FFlip-Clock%2Fcad%2Fr2%2FSTEP%2Fparts%2FA05_colon_0.step)
- [A05_colon_1](http://127.0.0.1:3245/?file=D%3A%2FProject%2FFlip-Clock%2Fcad%2Fr2%2FSTEP%2Fparts%2FA05_colon_1.step)
