zx90316/Flip-Clock/cad/r2/review_native/front.png

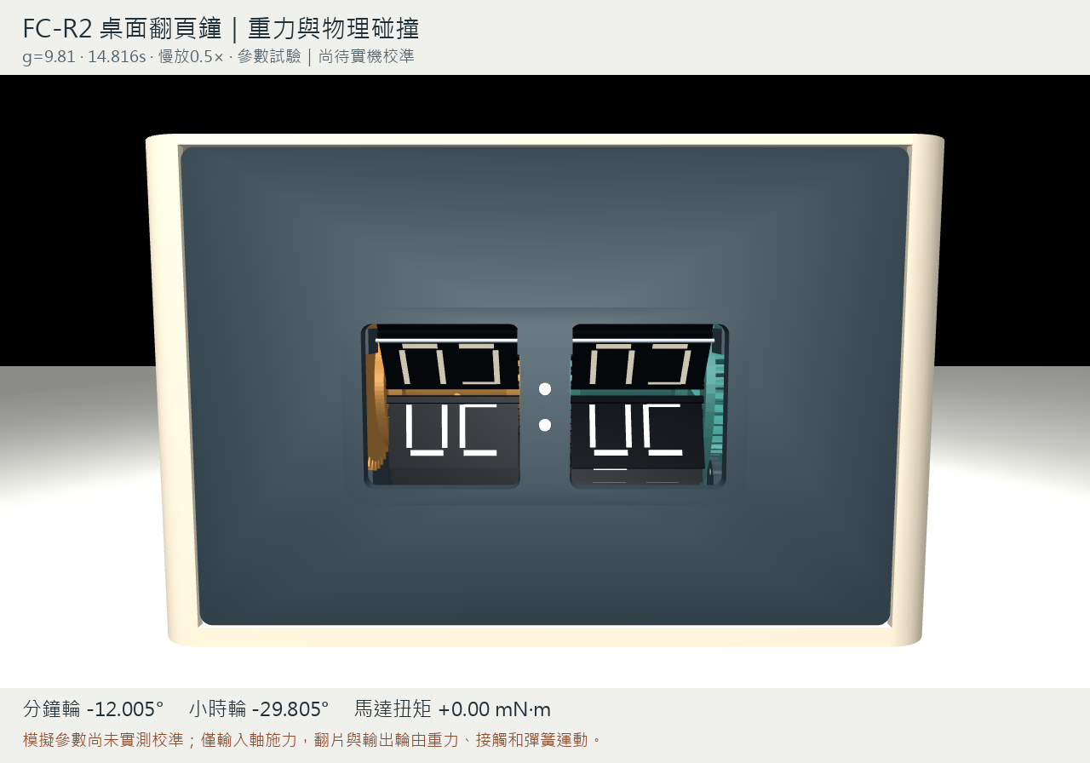
cad/r2/review_native/front.png
