zx90316/Flip-Clock/cad/reports/bom.csv

ID | quantity | material_proposal | print_orientation | STEP | STL | status
A00_base_L_rear | 1 | PETG proposal; bushings may be purchased POM | Z flat | STEP/parts/A00_base_L_rear.step | STL/prototype/A00_base_L_rear.stl | PASS
A00_base_L_front | 1 | PETG proposal; bushings may be purchased POM | Z flat | STEP/parts/A00_base_L_front.step | STL/prototype/A00_base_L_front.stl | PASS
A00_base_R_rear | 1 | PETG proposal; bushings may be purchased POM | Z flat | STEP/parts/A00_base_R_rear.step | STL/prototype/A00_base_R_rear.stl | PASS
A00_base_R_front | 1 | PETG proposal; bushings may be purchased POM | Z flat | STEP/parts/A00_base_R_front.step | STL/prototype/A00_base_R_front.stl | PASS
A03_X_seam_strap_rear | 1 | PETG proposal; bushings may be purchased POM | Z flat | STEP/parts/A03_X_seam_strap_rear.step | STL/prototype/A03_X_seam_strap_rear.stl | PASS
A03_X_seam_strap_front | 1 | PETG proposal; bushings may be purchased POM | Z flat | STEP/parts/A03_X_seam_strap_front.step | STL/prototype/A03_X_seam_strap_front.stl | PASS
A03_Y_seam_strap_L | 1 | PETG proposal; bushings may be purchased POM | Z flat | STEP/parts/A03_Y_seam_strap_L.step | STL/prototype/A03_Y_seam_strap_L.stl | PASS
A03_Y_seam_strap_R | 1 | PETG proposal; bushings may be purchased POM | Z flat | STEP/parts/A03_Y_seam_strap_R.step | STL/prototype/A03_Y_seam_strap_R.stl | PASS
A04_TPU_foot_0 | 4 | TPU proposal | Z flat | STEP/parts/A04_TPU_foot_0.step | STL/prototype/A04_TPU_foot_0.stl | PASS
A01_side_frame_M | 1 | PETG proposal; bushings may be purchased POM | X rotated 90 degrees about Y | STEP/parts/A01_side_frame_M.step | STL/prototype/A01_side_frame_M.stl | PASS
A01_side_frame_H | 1 | PETG proposal; bushings may be purchased POM | X rotated 90 degrees about Y | STEP/parts/A01_side_frame_H.step | STL/prototype/A01_side_frame_H.stl | PASS
A02_center_twin_bearing_pedestal | 1 | PETG proposal; bushings may be purchased POM | Y rotated 90 degrees about X | STEP/parts/A02_center_twin_bearing_pedestal.step | STL/prototype/A02_center_twin_bearing_pedestal.stl | PASS
A11_5_to_8_coupler | 1 | PETG proposal; bushings may be purchased POM | X rotated 90 degrees about Y | STEP/parts/A11_5_to_8_coupler.step | STL/prototype/A11_5_to_8_coupler.stl | PASS
A12_adjustable_motor_mount | 1 | PETG proposal; bushings may be purchased POM | X rotated 90 degrees about Y | STEP/parts/A12_adjustable_motor_mount.step | STL/prototype/A12_adjustable_motor_mount.stl | PASS
CM_output | 1 | PETG proposal; bushings may be purchased POM | X rotated 90 degrees about Y | STEP/parts/CM_output.step | STL/prototype/CM_output.stl | PASS
CM_carrier | 1 | PETG proposal; bushings may be purchased POM | X rotated 90 degrees about Y | STEP/parts/CM_carrier.step | STL/prototype/CM_carrier.stl | PASS
CM_pawl | 1 | PETG proposal; bushings may be purchased POM | X rotated 90 degrees about Y | STEP/parts/CM_pawl.step | STL/prototype/CM_pawl.stl | PASS
CM_bushing | 2 | PETG proposal; bushings may be purchased POM | X rotated 90 degrees about Y | STEP/parts/CM_bushing.step | STL/prototype/CM_bushing.stl | PASS
CM_cover | 2 | PETG proposal; bushings may be purchased POM | X rotated 90 degrees about Y | STEP/parts/CM_cover.step | STL/prototype/CM_cover.stl | PASS
CH_output | 1 | PETG proposal; bushings may be purchased POM | X rotated 90 degrees about Y | STEP/parts/CH_output.step | STL/prototype/CH_output.stl | PASS
CH_carrier | 1 | PETG proposal; bushings may be purchased POM | X rotated 90 degrees about Y | STEP/parts/CH_carrier.step | STL/prototype/CH_carrier.stl | PASS
CH_pawl | 1 | PETG proposal; bushings may be purchased POM | X rotated 90 degrees about Y | STEP/parts/CH_pawl.step | STL/prototype/CH_pawl.stl | PASS
A4M_drum_gear | 1 | PETG proposal; bushings may be purchased POM | X rotated 90 degrees about Y | STEP/parts/A4M_drum_gear.step | STL/prototype/A4M_drum_gear.stl | PASS
A40M_idler | 1 | PETG proposal; bushings may be purchased POM | X rotated 90 degrees about Y | STEP/parts/A40M_idler.step | STL/prototype/A40M_idler.stl | PASS
A4H_drum_gear | 1 | PETG proposal; bushings may be purchased POM | X rotated 90 degrees about Y | STEP/parts/A4H_drum_gear.step | STL/prototype/A4H_drum_gear.stl | PASS
DM_core | 2 | PETG proposal; bushings may be purchased POM | Y rotated 90 degrees about X | STEP/parts/DM_core.step | STL/prototype/DM_core.stl | PASS
DM_flange_L | 2 | PETG proposal; bushings may be purchased POM | X rotated 90 degrees about Y | STEP/parts/DM_flange_L.step | STL/prototype/DM_flange_L.stl | PASS
DH_flange_L | 2 | PETG proposal; bushings may be purchased POM | X rotated 90 degrees about Y | STEP/parts/DH_flange_L.step | STL/prototype/DH_flange_L.stl | PASS
DEM_scallop_disc | 1 | PETG proposal; bushings may be purchased POM | X rotated 90 degrees about Y | STEP/parts/DEM_scallop_disc.step | STL/prototype/DEM_scallop_disc.stl | PASS
DEM_pivot_arm | 1 | PETG proposal; bushings may be purchased POM | X rotated 90 degrees about Y | STEP/parts/DEM_pivot_arm.step | STL/prototype/DEM_pivot_arm.stl | PASS
DEM_bracket | 1 | PETG proposal; bushings may be purchased POM | X rotated 90 degrees about Y | STEP/parts/DEM_bracket.step | STL/prototype/DEM_bracket.stl | PASS
KM_forward_setting_knob | 2 | PETG proposal; bushings may be purchased POM | X rotated 90 degrees about Y | STEP/parts/KM_forward_setting_knob.step | STL/prototype/KM_forward_setting_knob.stl | PASS
RM_release_adjustment_rail | 1 | PETG proposal; bushings may be purchased POM | X rotated 90 degrees about Y | STEP/parts/RM_release_adjustment_rail.step | STL/prototype/RM_release_adjustment_rail.stl | PASS
RM_release_finger_RETRACTED | 1 | PETG proposal; bushings may be purchased POM | Y rotated 90 degrees about X | STEP/parts/RM_release_finger_RETRACTED.step | STL/prototype/RM_release_finger_RETRACTED.stl | PASS
DEH_scallop_disc | 1 | PETG proposal; bushings may be purchased POM | X rotated 90 degrees about Y | STEP/parts/DEH_scallop_disc.step | STL/prototype/DEH_scallop_disc.stl | PASS
DEH_pivot_arm | 1 | PETG proposal; bushings may be purchased POM | X rotated 90 degrees about Y | STEP/parts/DEH_pivot_arm.step | STL/prototype/DEH_pivot_arm.stl | PASS
DEH_bracket | 1 | PETG proposal; bushings may be purchased POM | X rotated 90 degrees about Y | STEP/parts/DEH_bracket.step | STL/prototype/DEH_bracket.stl | PASS
RH_release_adjustment_rail | 1 | PETG proposal; bushings may be purchased POM | X rotated 90 degrees about Y | STEP/parts/RH_release_adjustment_rail.step | STL/prototype/RH_release_adjustment_rail.stl | PASS
RH_release_finger_RETRACTED | 1 | PETG proposal; bushings may be purchased POM | Y rotated 90 degrees about X | STEP/parts/RH_release_finger_RETRACTED.step | STL/prototype/RH_release_finger_RETRACTED.stl | PASS
SH_adjustable_encoder_pedestal | 1 | PETG proposal; bushings may be purchased POM | X rotated 90 degrees about Y | STEP/parts/SH_adjustable_encoder_pedestal.step | STL/prototype/SH_adjustable_encoder_pedestal.stl | PASS
SH_magnet_cap | 2 | PETG proposal; bushings may be purchased POM | X rotated 90 degrees about Y | STEP/parts/SH_magnet_cap.step | STL/prototype/SH_magnet_cap.stl | PASS
SM_adjustable_encoder_pedestal | 1 | PETG proposal; bushings may be purchased POM | X rotated 90 degrees about Y | STEP/parts/SM_adjustable_encoder_pedestal.step | STL/prototype/SM_adjustable_encoder_pedestal.stl | PASS
GH_removable_side_panel | 1 | PETG proposal; bushings may be purchased POM | X rotated 90 degrees about Y | STEP/parts/GH_removable_side_panel.step | STL/prototype/GH_removable_side_panel.stl | PASS
GM_removable_side_panel | 1 | PETG proposal; bushings may be purchased POM | X rotated 90 degrees about Y | STEP/parts/GM_removable_side_panel.step | STL/prototype/GM_removable_side_panel.stl | PASS
CP_M24_output | 1 | PETG proposal; bushings may be purchased POM | Z flat | STEP/parts/CP_M24_output.step | STL/prototype/CP_M24_output.stl | PASS
CP_M36_output | 1 | PETG proposal; bushings may be purchased POM | Z flat | STEP/parts/CP_M36_output.step | STL/prototype/CP_M36_output.stl | PASS
CP_M48_output | 1 | PETG proposal; bushings may be purchased POM | Z flat | STEP/parts/CP_M48_output.step | STL/prototype/CP_M48_output.stl | PASS
CP_H36_output | 1 | PETG proposal; bushings may be purchased POM | Z flat | STEP/parts/CP_H36_output.step | STL/prototype/CP_H36_output.stl | PASS
CP_8mm_fit_ladder | 1 | PETG proposal; bushings may be purchased POM | Z flat | STEP/parts/CP_8mm_fit_ladder.step | STL/prototype/CP_8mm_fit_ladder.stl | PASS
CP_flap_hinge_blank | 1 | PETG proposal; bushings may be purchased POM | Z flat | STEP/parts/CP_flap_hinge_blank.step | STL/prototype/CP_flap_hinge_blank.stl | PASS
FM_00_complete_numbered_flap | 1 | PETG proposal; bushings may be purchased POM | Y rotated 90 degrees about X | STEP/parts/FM_00_complete_numbered_flap.step | STL/prototype/FM_00_complete_numbered_flap.stl | PASS
FM_01_complete_numbered_flap | 1 | PETG proposal; bushings may be purchased POM | Y rotated 90 degrees about X | STEP/parts/FM_01_complete_numbered_flap.step | STL/prototype/FM_01_complete_numbered_flap.stl | PASS
FM_02_complete_numbered_flap | 1 | PETG proposal; bushings may be purchased POM | Y rotated 90 degrees about X | STEP/parts/FM_02_complete_numbered_flap.step | STL/prototype/FM_02_complete_numbered_flap.stl | PASS
FM_03_complete_numbered_flap | 1 | PETG proposal; bushings may be purchased POM | Y rotated 90 degrees about X | STEP/parts/FM_03_complete_numbered_flap.step | STL/prototype/FM_03_complete_numbered_flap.stl | PASS
FM_04_complete_numbered_flap | 1 | PETG proposal; bushings may be purchased POM | Y rotated 90 degrees about X | STEP/parts/FM_04_complete_numbered_flap.step | STL/prototype/FM_04_complete_numbered_flap.stl | PASS
FM_05_complete_numbered_flap | 1 | PETG proposal; bushings may be purchased POM | Y rotated 90 degrees about X | STEP/parts/FM_05_complete_numbered_flap.step | STL/prototype/FM_05_complete_numbered_flap.stl | PASS
FM_06_complete_numbered_flap | 1 | PETG proposal; bushings may be purchased POM | Y rotated 90 degrees about X | STEP/parts/FM_06_complete_numbered_flap.step | STL/prototype/FM_06_complete_numbered_flap.stl | PASS
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
FH_23_complete_numbered_flap | 1 | PETG proposal; bushings may be purchased POM | Y rotated 90 degrees about X | STEP/parts/FH_23_complete_numbered_flap.step | STL/prototype/FH_23_complete_numbered_flap.stl | PASS
C_cover_spacer | 6 | PETG proposal | Z flat | STEP/parts/C_cover_spacer.step | STL/prototype/C_cover_spacer.stl | PASS
