zx90316/Flip-Clock/cad/r2/review_native/comparison/20261105T081556_663338Z_drive/model/assets/pawl_H_0.stl

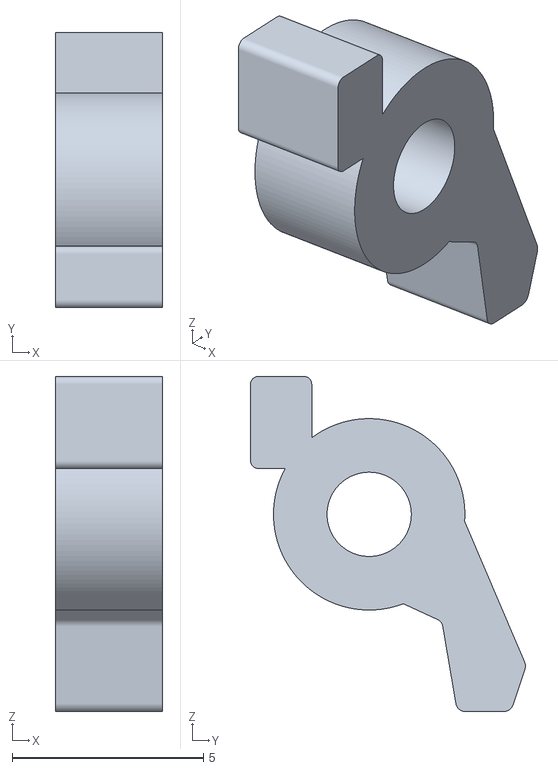
[picture p3: CAD file, 2026-11-06]
cad/r2/review_native/comparison/20261105T081556_663338Z_drive/model/assets/pawl_H_0.stl
2.80 x 7.18 x 8.75
