zx90316/Flip-Clock/cad/review/physics/model/assets/drum_M_M_2.stl

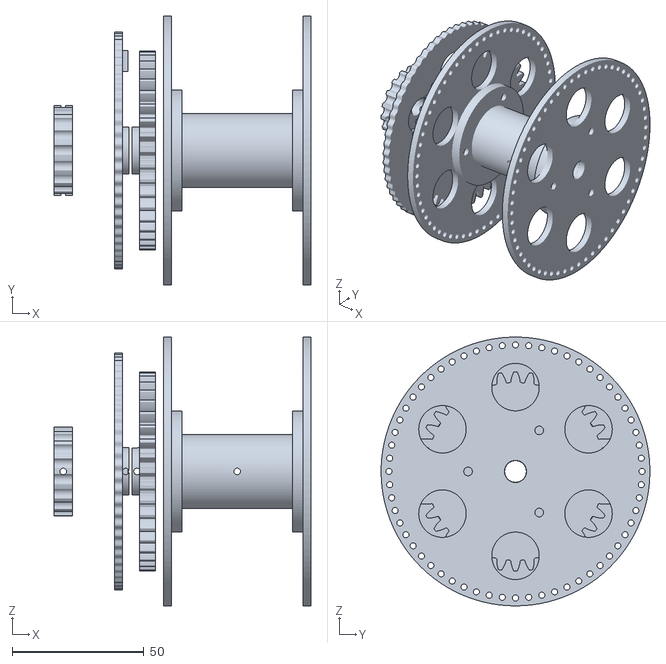
[picture p4: CAD file, 2026-11-04]
cad/review/physics/model/assets/drum_M_M_2.stl
97.5 x 102.0 x 102.0
