zx90316/Flip-Clock/cad/review/physics/model/assets/drum_M_ivory_2.stl

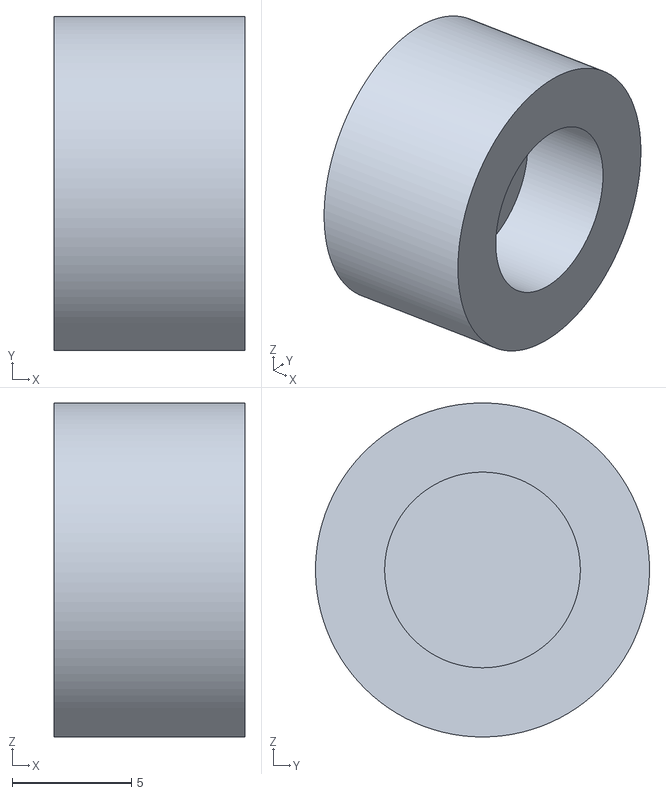
[picture p5: CAD file, 2026-11-04]
cad/review/physics/model/assets/drum_M_ivory_2.stl
8.00 x 14.0 x 14.0
