zx90316/Flip-Clock/cad/r2/review_native/comparison/20261105T081556_663338Z_drive/model/assets/input_1.stl

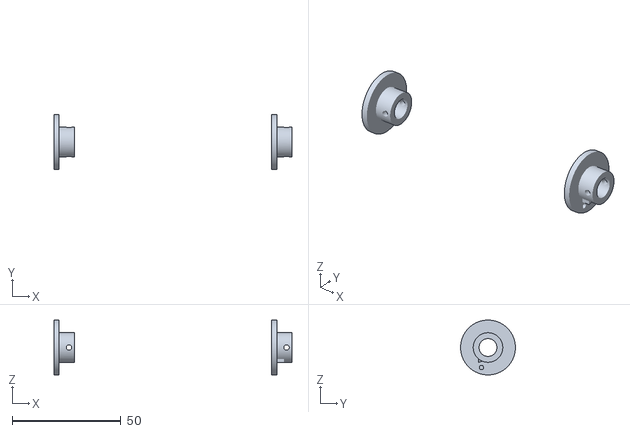
[picture p6: CAD file, 2026-11-06]
cad/r2/review_native/comparison/20261105T081556_663338Z_drive/model/assets/input_1.stl
109.4 x 25.2 x 25.2
