zx90316/Flip-Clock/cad/review/physics/model/assets/arm_H_ivory_2.stl

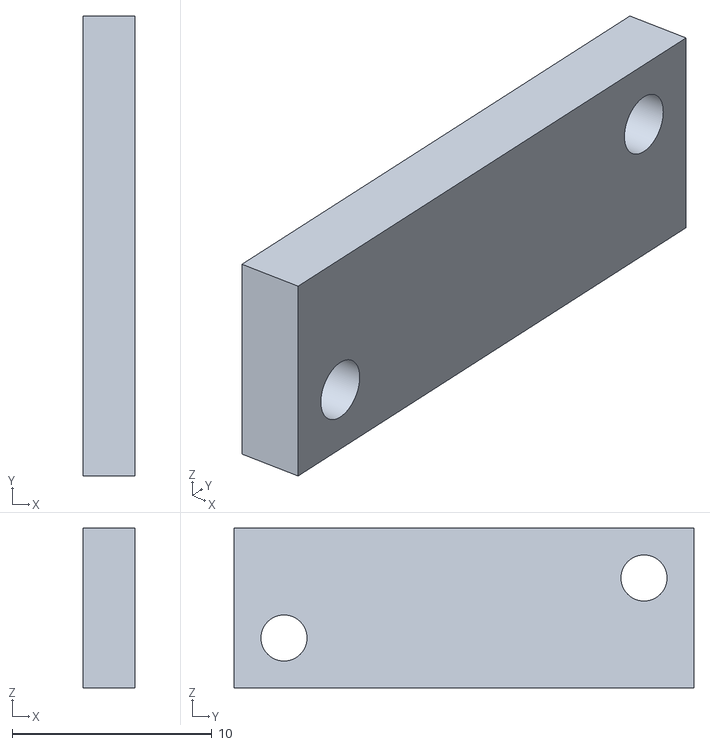
[picture p7: CAD file, 2026-11-04]
cad/review/physics/model/assets/arm_H_ivory_2.stl
2.60 x 23.0 x 8.00
