zx90316/Flip-Clock/cad/r2/review_native/comparison/20261105T081556_663338Z_drive/model/assets/world_2.stl

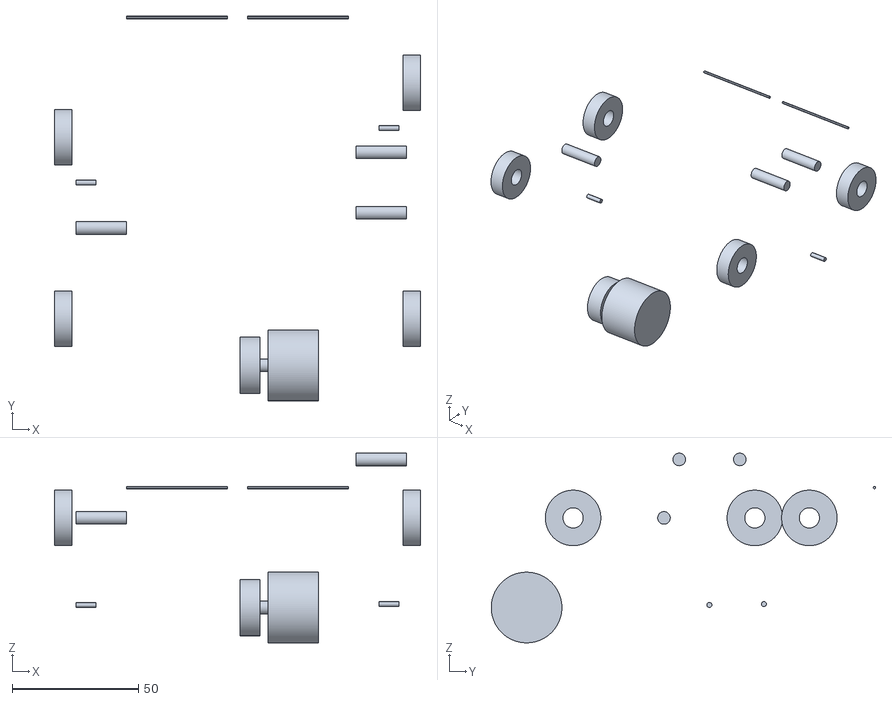
[picture p8: CAD file, 2026-11-05]
cad/r2/review_native/comparison/20261105T081556_663338Z_drive/model/assets/world_2.stl
145.0 x 152.3 x 75.2
