zx90316/Flip-Clock/cad/r2/review_native/model/assets/world_4.stl

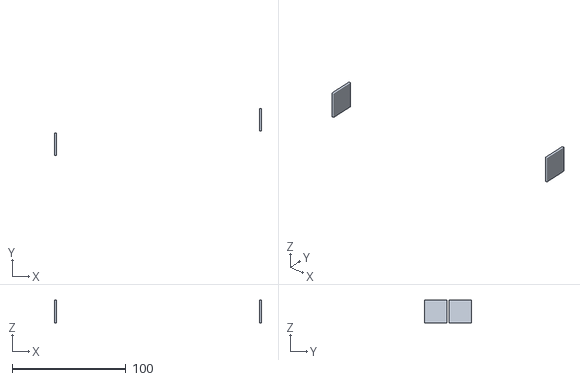
[picture p9: CAD file, 2026-11-05]
cad/r2/review_native/model/assets/world_4.stl
181.6 x 41.6 x 20.0
