zx90316/Flip-Clock/cad/review/physics/model/assets/world_pcb_2.stl

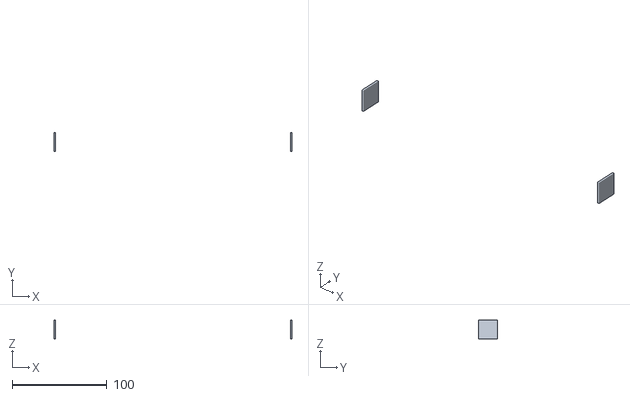
[picture p10: CAD file, 2026-11-04]
cad/review/physics/model/assets/world_pcb_2.stl
250.6 x 20.0 x 20.0
