zx90316/Flip-Clock/cad/r2/review_native/comparison/20261105T081556_663338Z_drive/model/assets/arm_M_0.stl

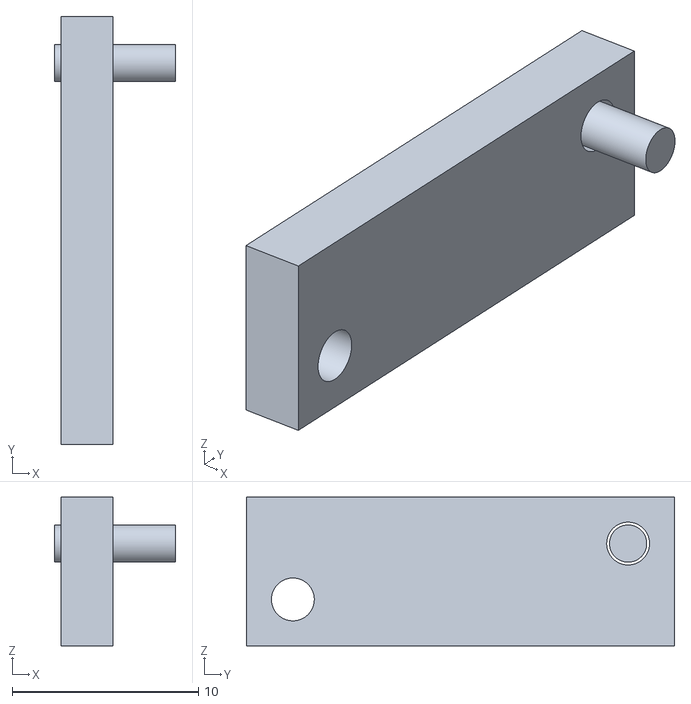
[picture p11: CAD file, 2026-11-05]
cad/r2/review_native/comparison/20261105T081556_663338Z_drive/model/assets/arm_M_0.stl
6.50 x 23.0 x 8.00
