zx90316/Flip-Clock/cad/review/physics/model/assets/roller_M_steel_2.stl

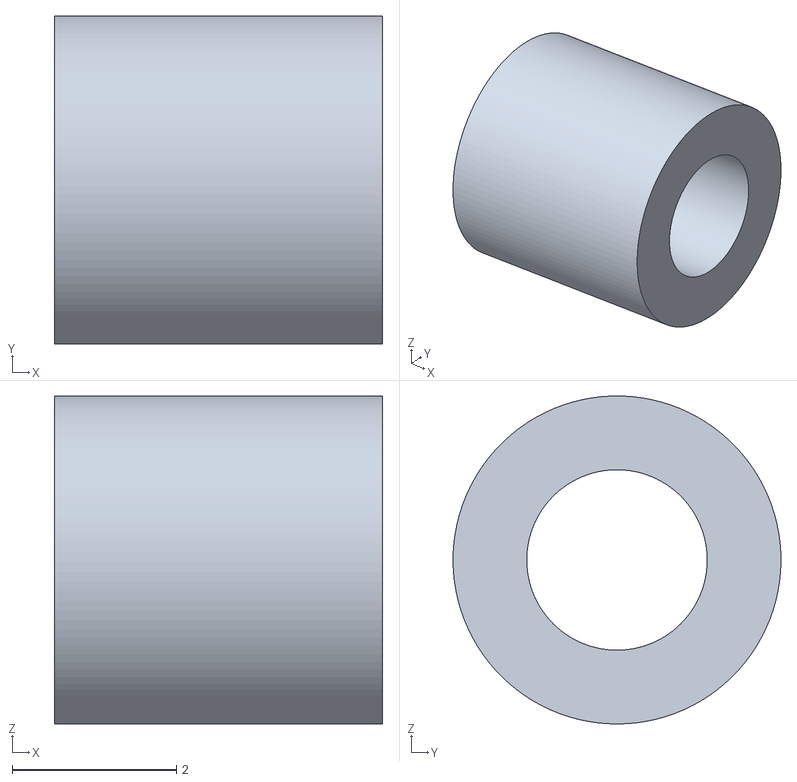
[picture p12: CAD file, 2026-11-04]
cad/review/physics/model/assets/roller_M_steel_2.stl
4.00 x 4.00 x 4.00
