zx90316/Flip-Clock/cad/r2/review_native/comparison/20261105T081556_663338Z_drive/model/assets/idler_0.stl

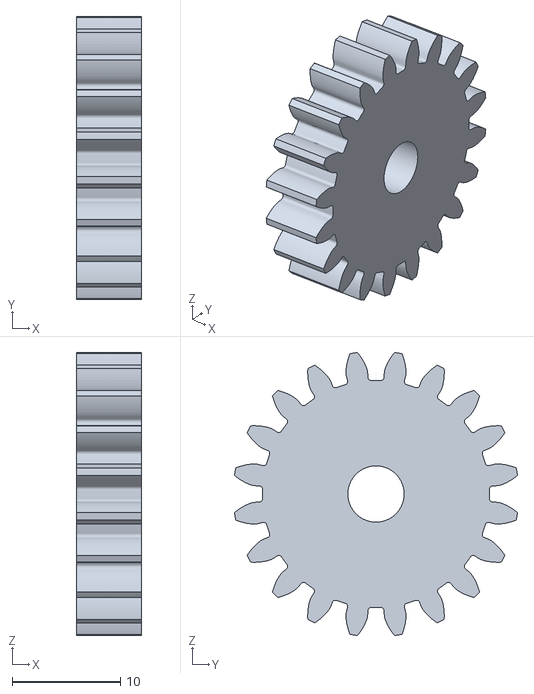
[picture p13: CAD file, 2026-11-05]
cad/r2/review_native/comparison/20261105T081556_663338Z_drive/model/assets/idler_0.stl
6.00 x 26.2 x 26.2
