zx90316/Flip-Clock/cad/r2/review_native/model/assets/world_1.stl

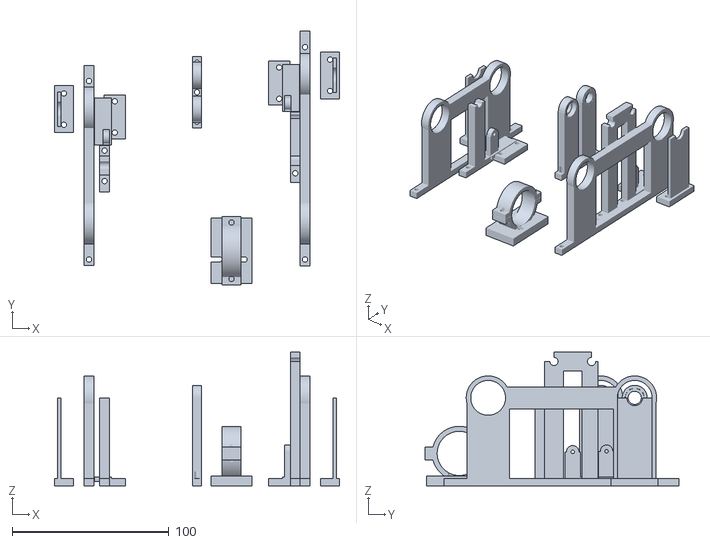
[picture p14: CAD file, 2026-11-05]
cad/r2/review_native/model/assets/world_1.stl
182.0 x 162.0 x 85.4
