zx90316/Flip-Clock/cad/review/physics/model/assets/world_ivory_2.stl

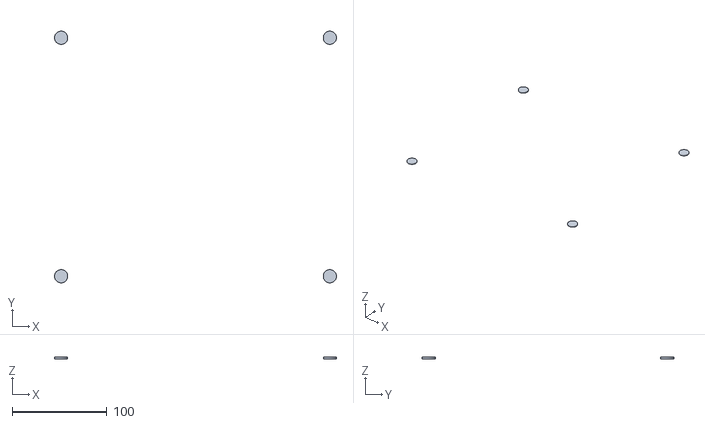
[picture p15: CAD file, 2026-11-04]
cad/review/physics/model/assets/world_ivory_2.stl
298.0 x 266.0 x 2.00
