zx90316/Flip-Clock/cad/r2/review_native/model/assets/world_6.stl

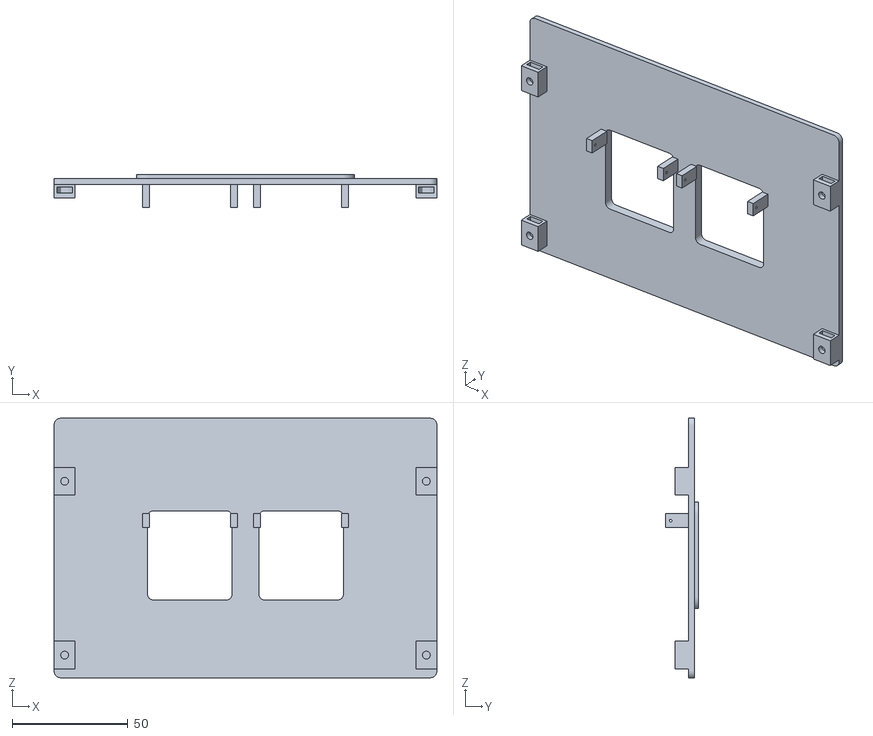
[picture p16: CAD file, 2026-11-05]
cad/r2/review_native/model/assets/world_6.stl
165.2 x 14.2 x 112.0
