zx90316/Flip-Clock/cad/review/physics/model/assets/ring_H_ivory_2.stl

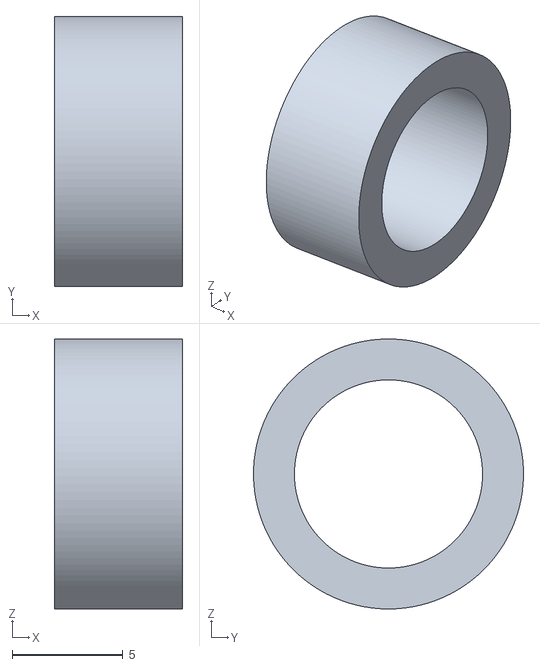
[picture p17: CAD file, 2026-11-04]
cad/review/physics/model/assets/ring_H_ivory_2.stl
5.80 x 12.2 x 12.2
