zx90316/Flip-Clock/cad/r2/review_native/comparison/20261105T081556_663338Z_drive/model/assets/world_0.stl

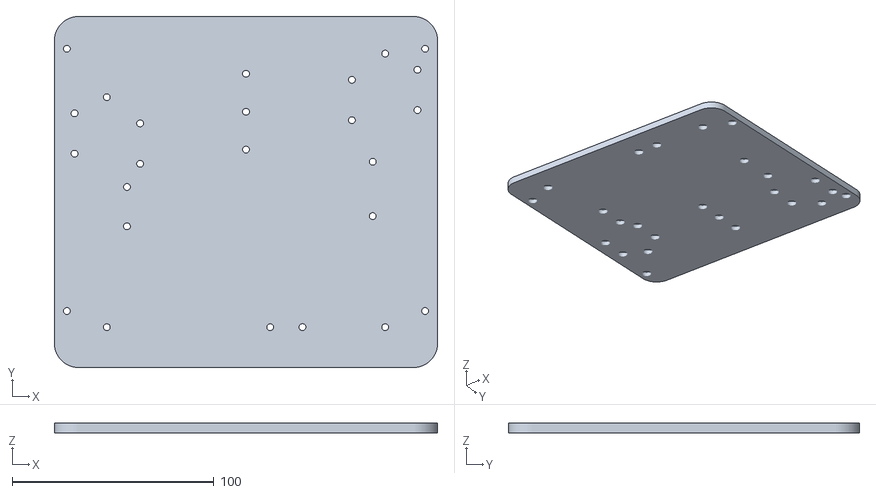
[picture p18: CAD file, 2026-11-05]
cad/r2/review_native/comparison/20261105T081556_663338Z_drive/model/assets/world_0.stl
190.0 x 174.0 x 4.80
