zx90316/Flip-Clock/cad/review/physics/model/assets/world_frame_2.stl

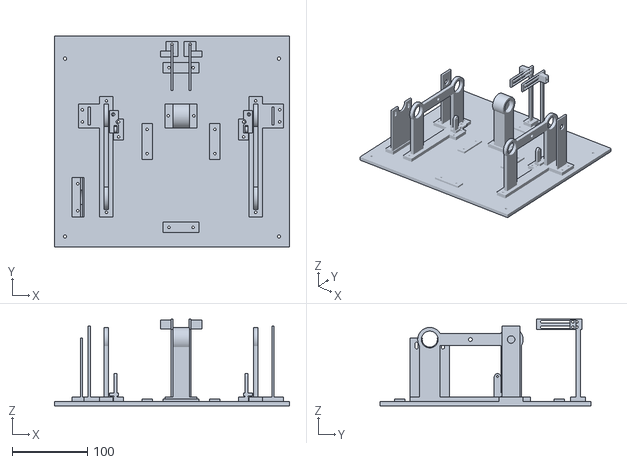
[picture p19: CAD file, 2026-11-04]
cad/review/physics/model/assets/world_frame_2.stl
312.0 x 280.0 x 115.0
