zx90316/Flip-Clock/cad/review/physics/model/assets/input_H_2.stl

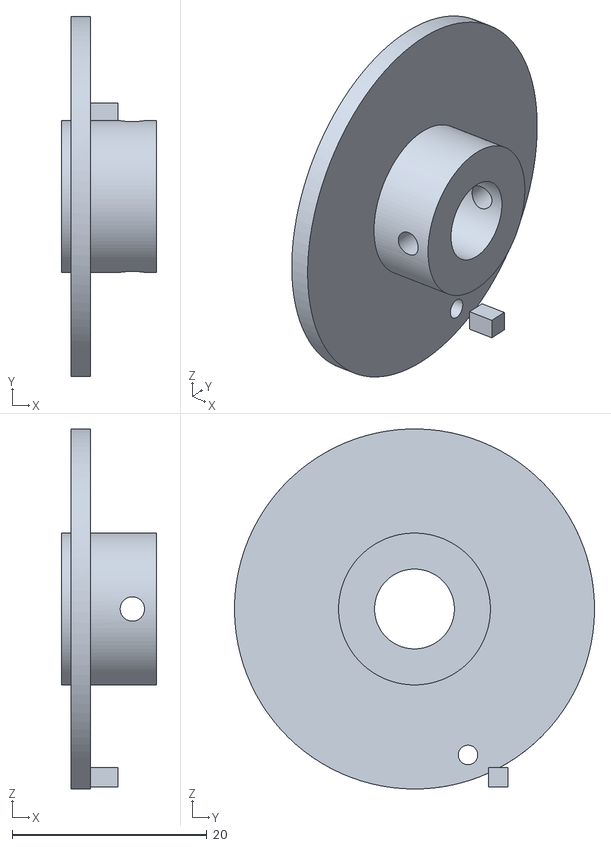
[picture p20: CAD file, 2026-11-04]
cad/review/physics/model/assets/input_H_2.stl
9.80 x 37.0 x 37.0
