zx90316/Flip-Clock/cad/r2/review_native/comparison/20261105T081556_663338Z_drive/model/assets/drum_M_0.stl

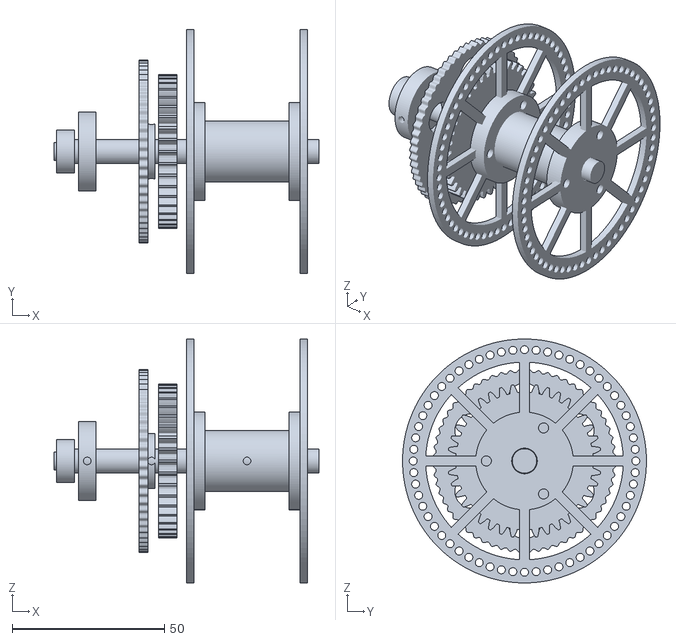
[picture p21: CAD file, 2026-11-05]
cad/r2/review_native/comparison/20261105T081556_663338Z_drive/model/assets/drum_M_0.stl
86.9 x 80.0 x 80.0
