zx90316/Flip-Clock/cad/r2/review_native/model/assets/world_7.stl

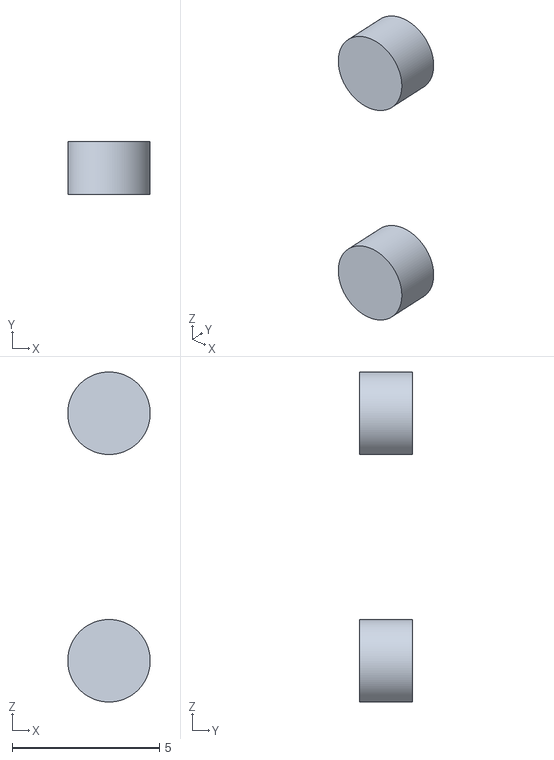
[picture p22: CAD file, 2026-11-05]
cad/r2/review_native/model/assets/world_7.stl
2.80 x 1.80 x 11.2
