zx90316/Flip-Clock/cad/review/physics/model/assets/ring_M_M_2.stl

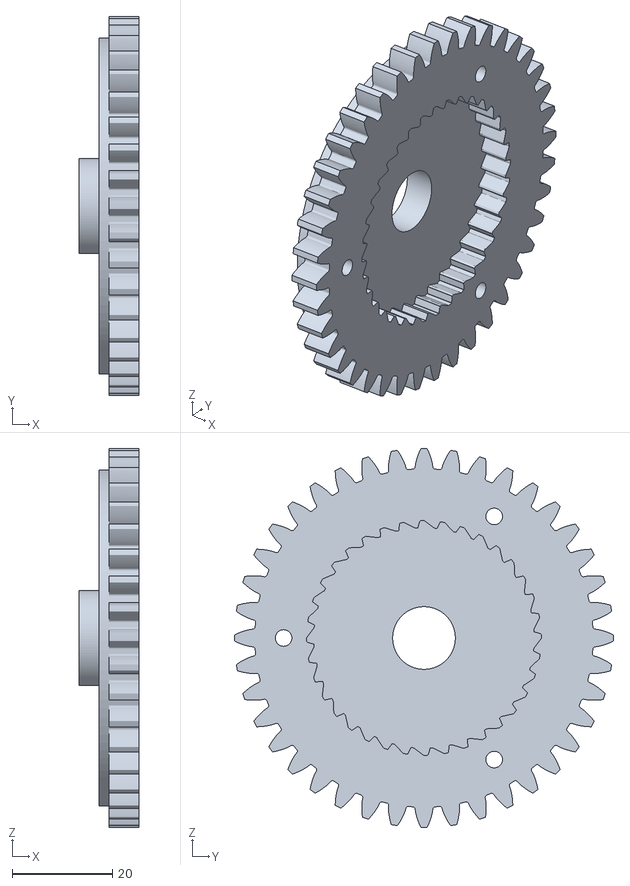
[picture p23: CAD file, 2026-11-04]
cad/review/physics/model/assets/ring_M_M_2.stl
12.0 x 75.6 x 75.6
