zx90316/Flip-Clock/cad/r2/review_native/model/assets/ring_H_0.stl

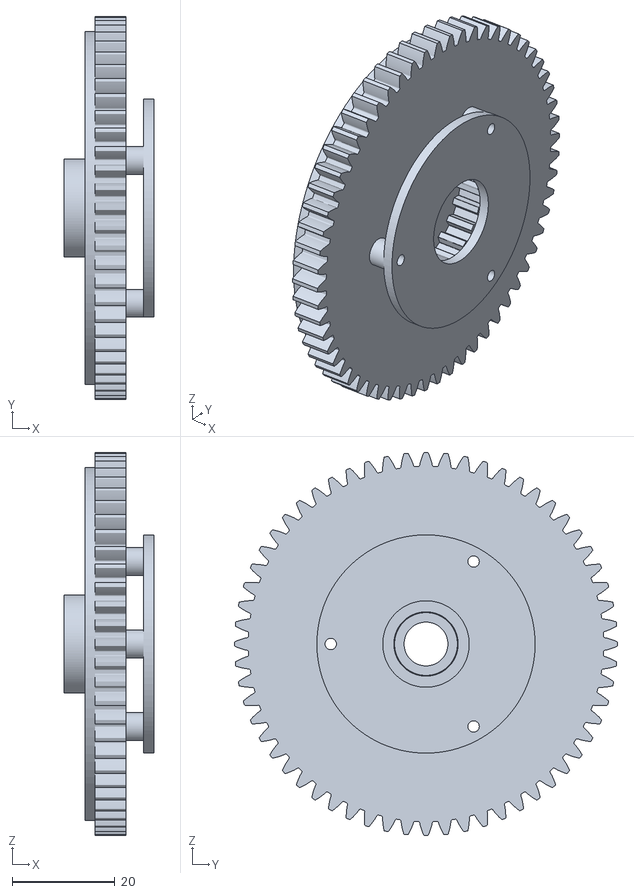
[picture p25: CAD file, 2026-11-05]
cad/r2/review_native/model/assets/ring_H_0.stl
17.4 x 74.4 x 74.4
