zx90316/Flip-Clock/cad/review/physics/model/assets/input_M_2.stl

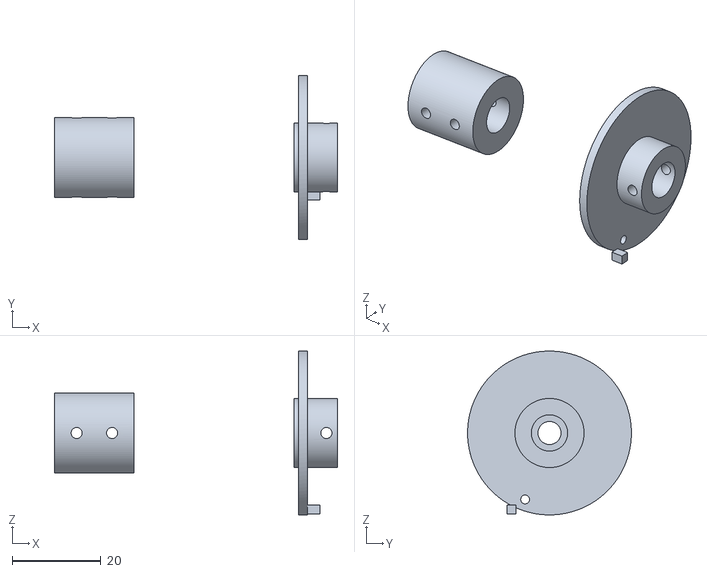
[picture p26: CAD file, 2026-11-04]
cad/review/physics/model/assets/input_M_2.stl
63.9 x 37.0 x 37.0
