zx90316/Flip-Clock/cad/review/physics/model/assets/drum_M_steel_2.stl

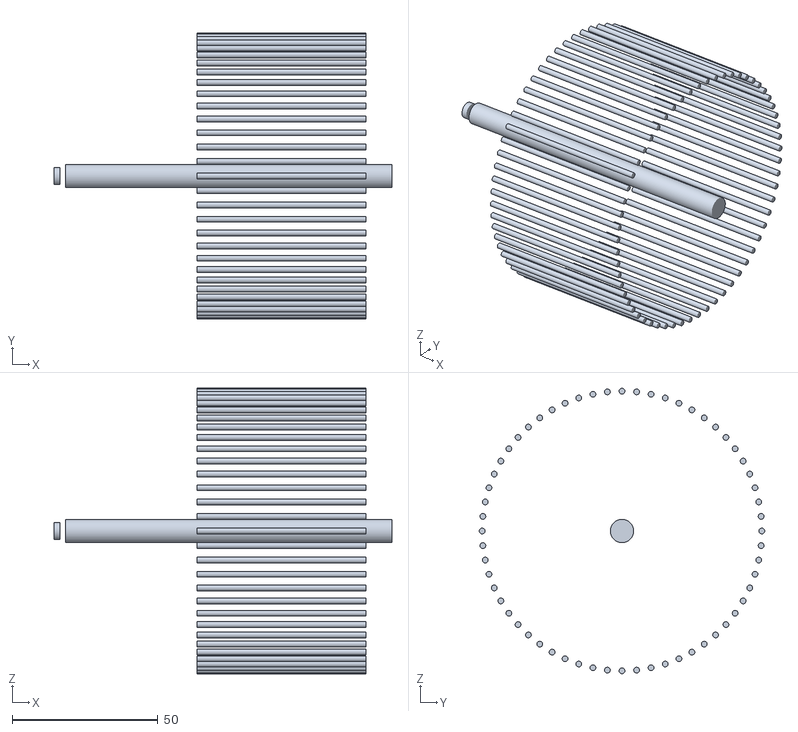
[picture p27: CAD file, 2026-11-04]
cad/review/physics/model/assets/drum_M_steel_2.stl
116.0 x 98.0 x 98.0
