zx90316/Flip-Clock/cad/r2/review_native/model/assets/input_0.stl

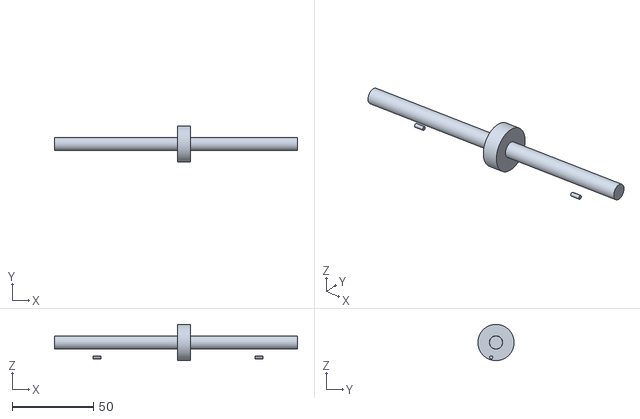
[picture p28: CAD file, 2026-11-05]
cad/r2/review_native/model/assets/input_0.stl
150.0 x 22.4 x 22.4
