zx90316/Flip-Clock/cad/review/physics/model/assets/ring_M_M_4.stl

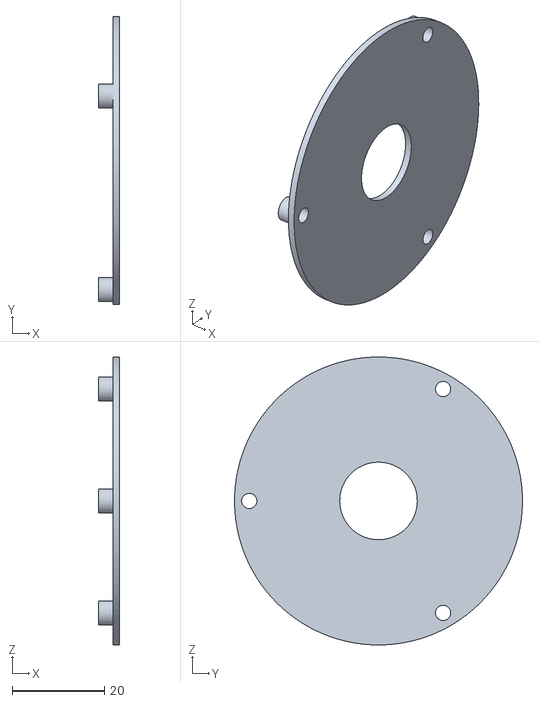
[picture p29: CAD file, 2026-11-04]
cad/review/physics/model/assets/ring_M_M_4.stl
4.65 x 62.4 x 62.4
