zx90316/Flip-Clock/cad/r2/review_native/model/assets/ring_M_0.stl

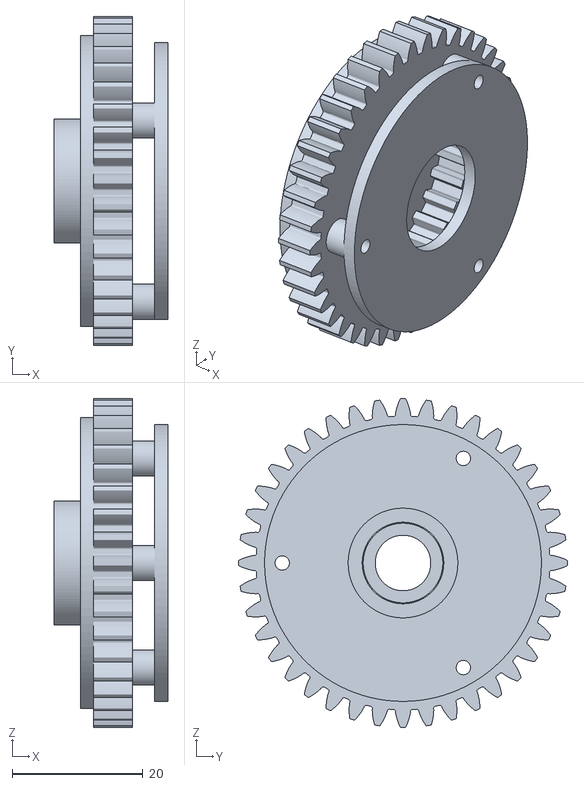
[picture p30: CAD file, 2026-11-05]
cad/r2/review_native/model/assets/ring_M_0.stl
17.4 x 50.4 x 50.4
