zx90316/Flip-Clock/cad/r2/review_native/model/assets/world_3.stl

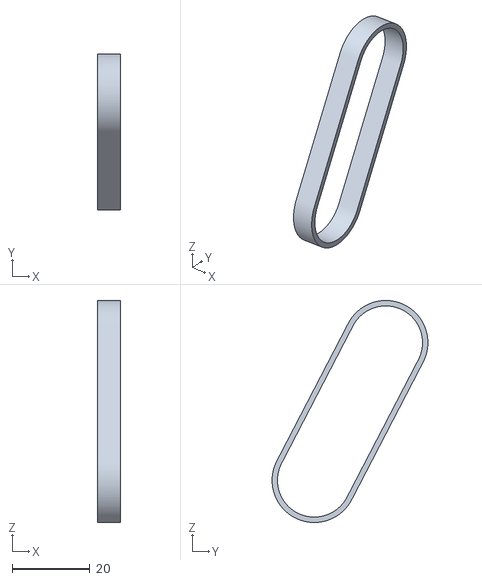
[picture p31: CAD file, 2026-11-05]
cad/r2/review_native/model/assets/world_3.stl
6.00 x 40.2 x 57.3
