zx90316/Flip-Clock/cad/review/physics/model/assets/arm_M_steel_2.stl

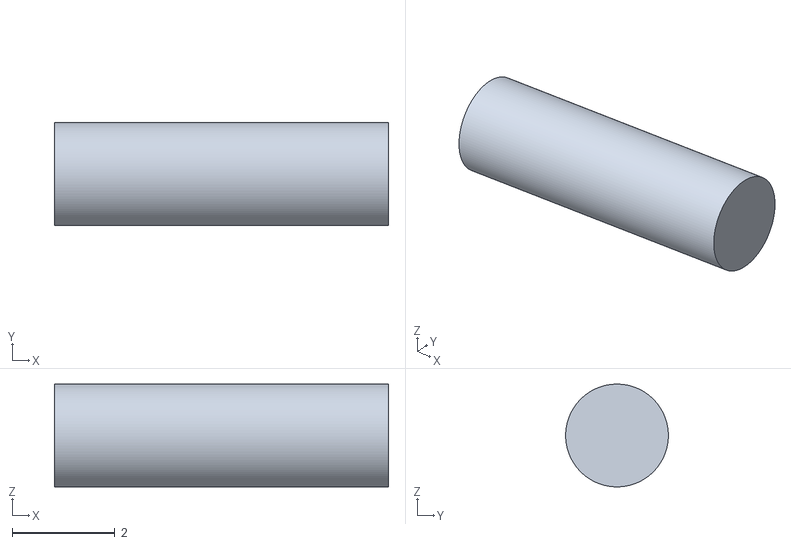
[picture p32: CAD file, 2026-11-04]
cad/review/physics/model/assets/arm_M_steel_2.stl
6.50 x 2.00 x 2.00
