zx90316/Flip-Clock/cad/r2/review_native/model/assets/drum_H_0.stl

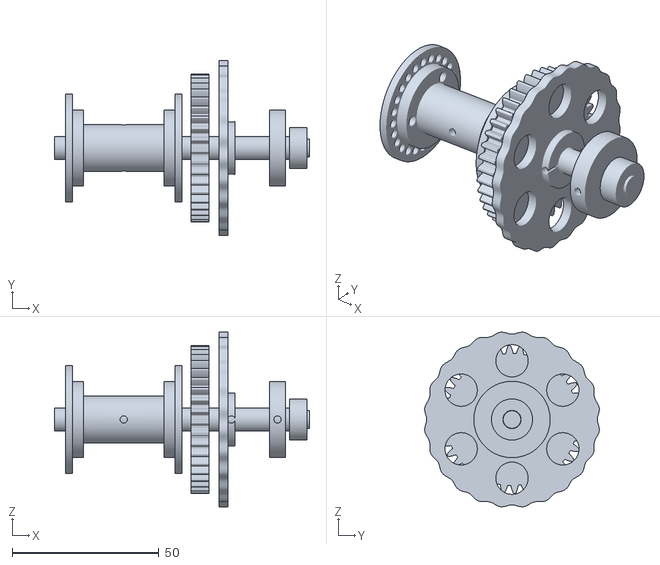
[picture p33: CAD file, 2026-11-05]
cad/r2/review_native/model/assets/drum_H_0.stl
86.9 x 59.5 x 59.5
