zx90316/Flip-Clock/cad/review/physics/model/assets/pawl_M_M_2.stl

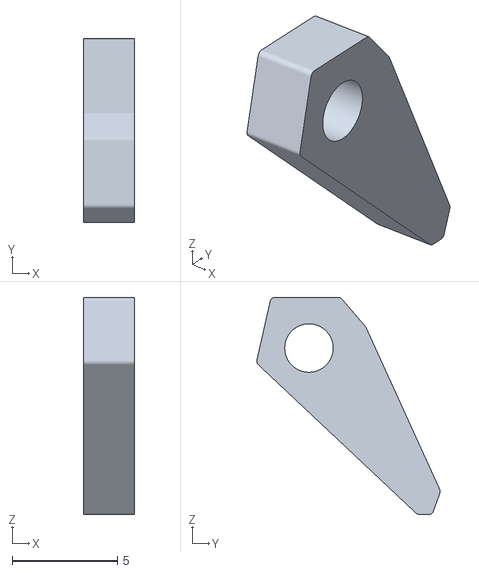
[picture p34: CAD file, 2026-11-04]
cad/review/physics/model/assets/pawl_M_M_2.stl
2.40 x 8.71 x 10.3
