zx90316/Flip-Clock/cad/review/physics/model/assets/world_steel_2.stl

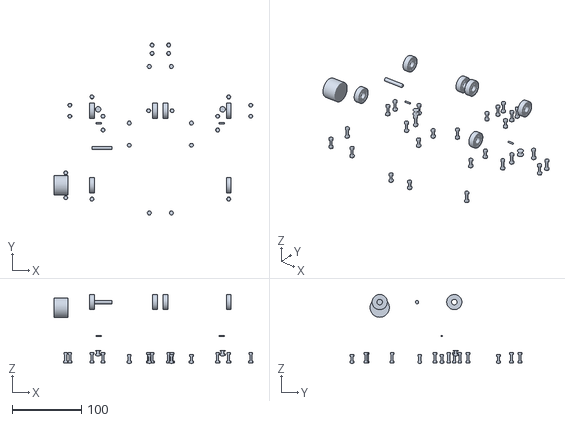
[picture p35: CAD file, 2026-11-04]
cad/review/physics/model/assets/world_steel_2.stl
288.2 x 248.5 x 100.0
