zx90316/Flip-Clock/cad/review/physics/model/assets/drum_H_steel_2.stl

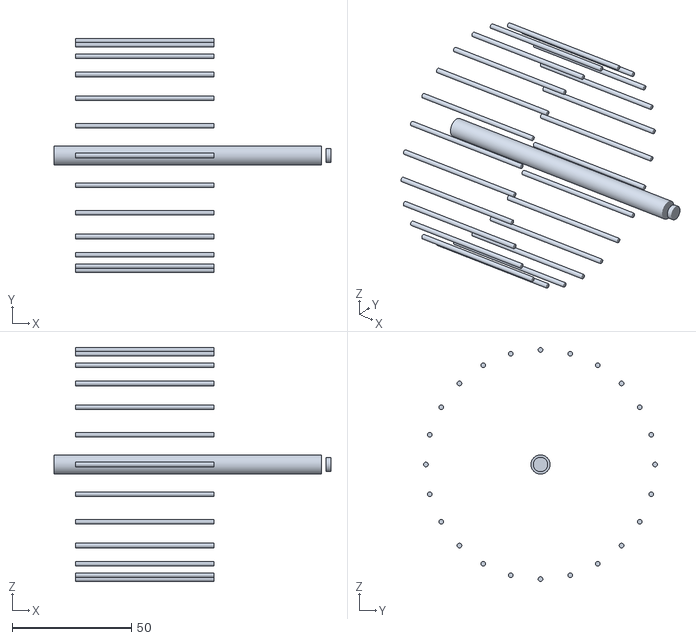
[picture p36: CAD file, 2026-11-04]
cad/review/physics/model/assets/drum_H_steel_2.stl
116.0 x 98.0 x 98.0
