zx90316/Flip-Clock/cad/r2/review_native/model/assets/flap_blank.stl

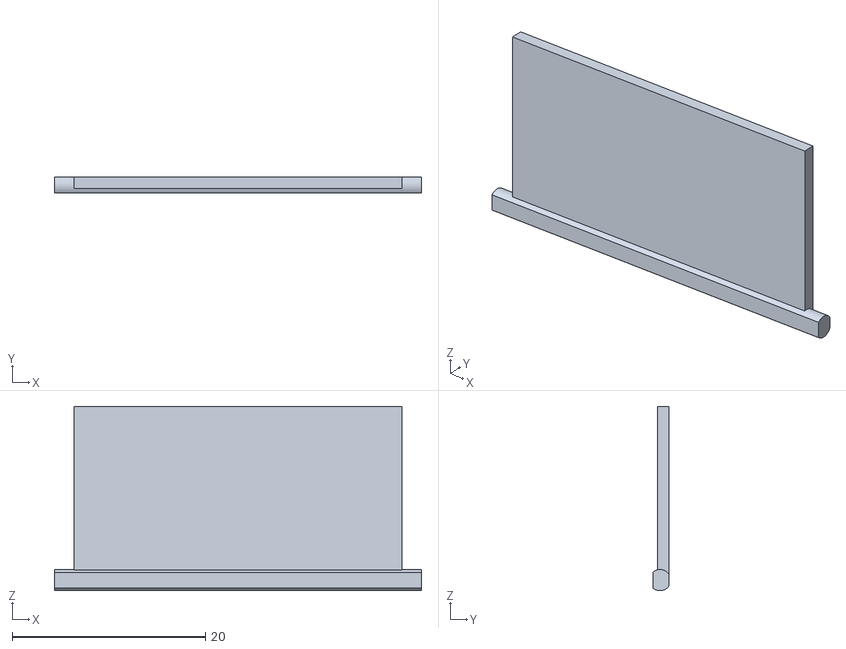
[picture p37: CAD file, 2026-11-05]
cad/r2/review_native/model/assets/flap_blank.stl
38.0 x 1.70 x 19.1
