zx90316/Flip-Clock/cad/review/physics/model/assets/idler_ivory_2.stl

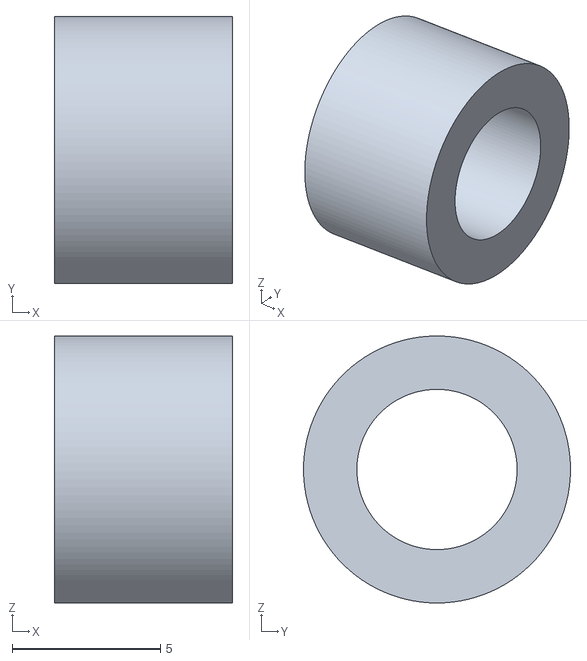
[picture p38: CAD file, 2026-11-04]
cad/review/physics/model/assets/idler_ivory_2.stl
6.00 x 9.00 x 9.00
