zx90316/Flip-Clock/cad/review/physics/model/assets/flap_blank.stl

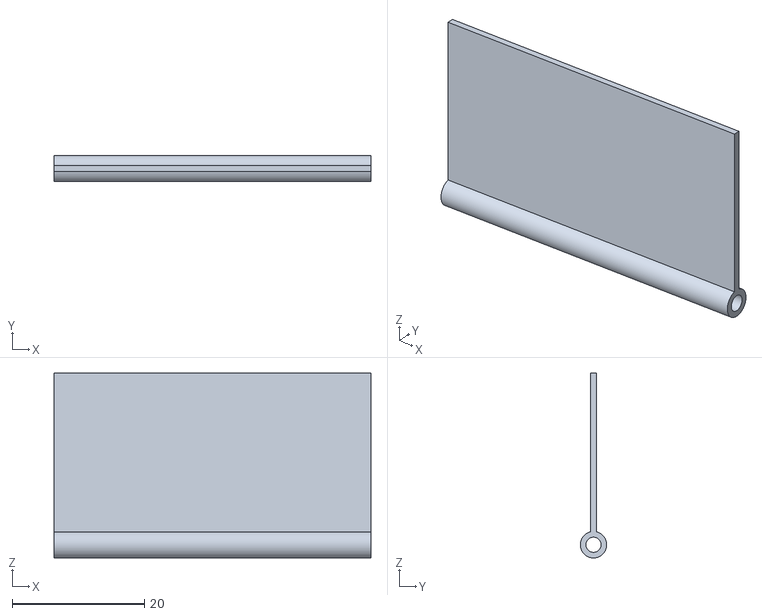
[picture p39: CAD file, 2026-11-04]
cad/review/physics/model/assets/flap_blank.stl
48.0 x 4.00 x 28.0
