zx90316/Flip-Clock/cad/review/physics/model/assets/input_steel_2.stl

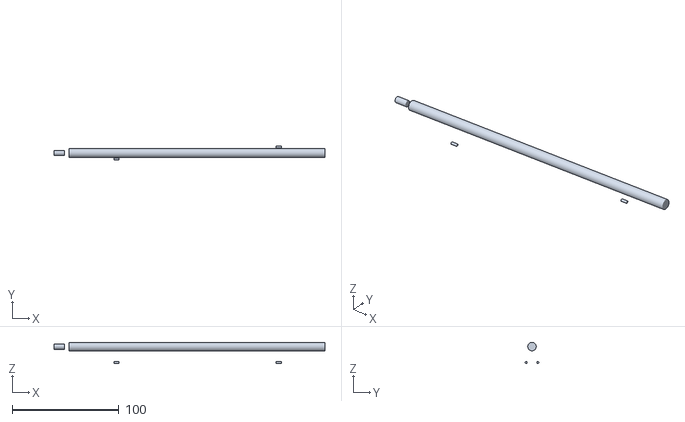
[picture p40: CAD file, 2026-11-04]
cad/review/physics/model/assets/input_steel_2.stl
254.0 x 13.0 x 20.0
