zx90316/Flip-Clock/cad/review/physics/model/assets/drum_H_H_2.stl

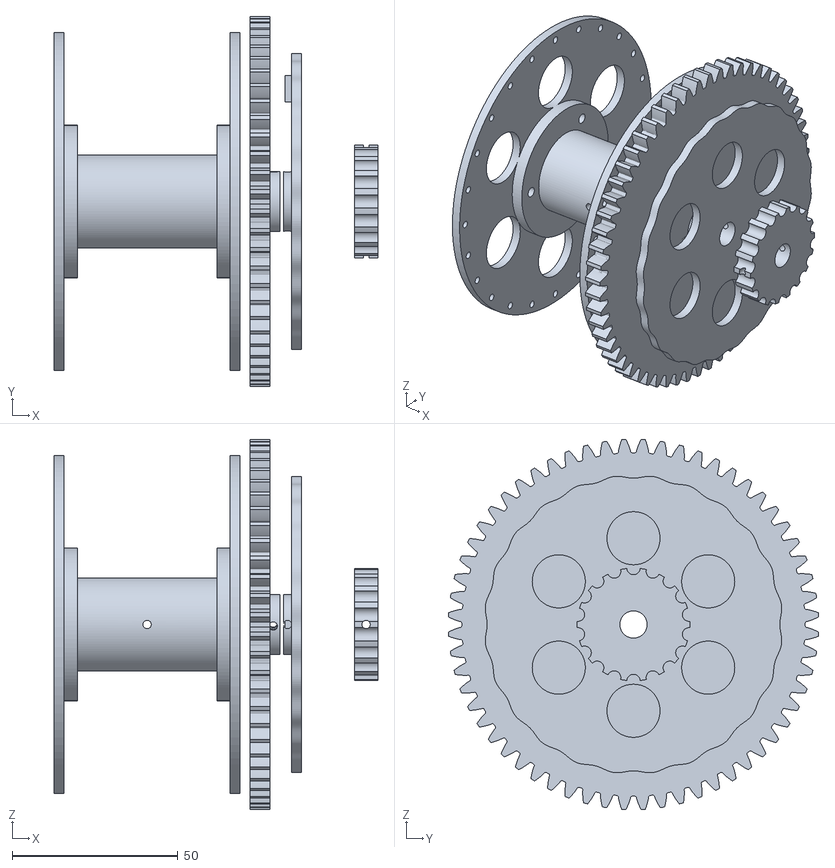
[picture p41: CAD file, 2026-11-04]
cad/review/physics/model/assets/drum_H_H_2.stl
97.5 x 111.5 x 111.5
