zx90316/Flip-Clock/cad/review/physics/model/assets/ring_H_H_2.stl

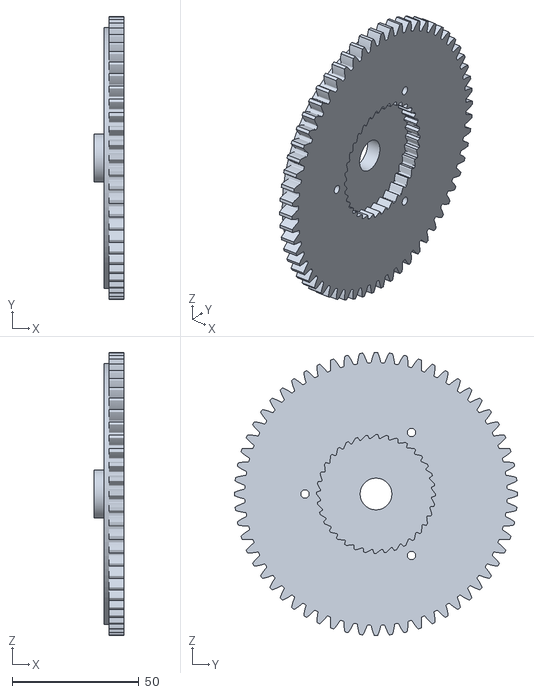
[picture p42: CAD file, 2026-11-04]
cad/review/physics/model/assets/ring_H_H_2.stl
12.0 x 111.6 x 111.6
