zx90316/Flip-Clock/cad/review/physics/model/assets/idler_frame_2.stl

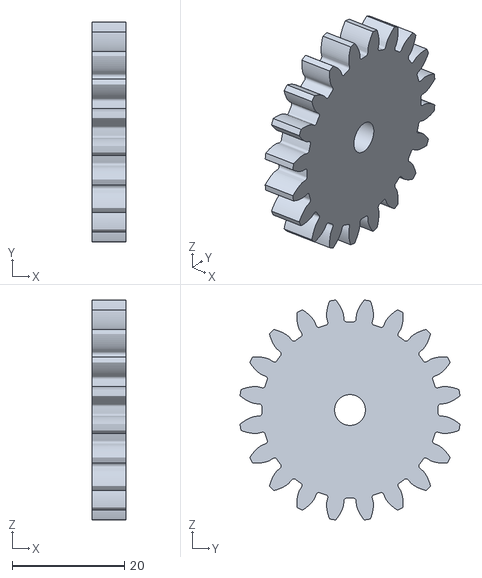
[picture p43: CAD file, 2026-11-04]
cad/review/physics/model/assets/idler_frame_2.stl
6.00 x 39.3 x 39.3
