zx90316/Flip-Clock/cad/review/physics/model/assets/world_guard_4.stl

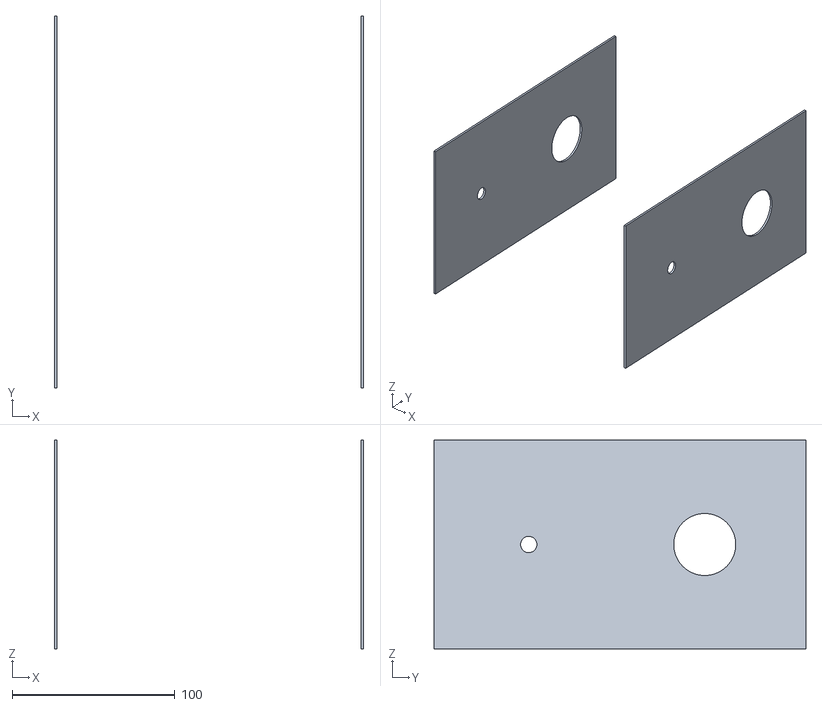
[picture p44: CAD file, 2026-11-04]
cad/review/physics/model/assets/world_guard_4.stl
189.6 x 228.0 x 128.0
