zx90316/Flip-Clock/(list of files, cad)

Other CAD files:
cad/r2/review_native/model/assets/pawl_M_0.stl
cad/r2/review_native/comparison/20261105T081556_663338Z_drive/model/assets/pawl_M_0.stl
cad/r2/review_native/model/assets/arm_H_0.stl
cad/r2/review_native/comparison/20261105T081556_663338Z_drive/model/assets/arm_H_0.stl
cad/r2/review_native/comparison/20261105T081556_663338Z_drive/model/assets/h_idler_0_0.stl
cad/r2/review_native/model/assets/h_idler_1_0.stl
cad/r2/review_native/comparison/20261105T081556_663338Z_drive/model/assets/h_idler_1_0.stl
cad/review/physics/model/assets/drum_H_ivory_2.stl
cad/r2/review_native/comparison/20261105T081556_663338Z_drive/model/assets/roller_M_0.stl
cad/r2/review_native/comparison/20261105T081556_663338Z_drive/model/assets/roller_H_0.stl
cad/r2/review_native/model/assets/roller_H_0.stl
cad/review/physics/model/assets/arm_H_steel_2.stl
cad/r2/review_native/model/assets/roller_M_0.stl
cad/r2/review_native/model/assets/h_idler_0_0.stl
cad/review/physics/model/assets/pawl_H_H_2.stl
