zx90316/Flip-Clock/docs/esp32_clock-build.txt

Sketch uses 1349274 bytes (68%) of program storage space. Maximum is 1966080 bytes.
Global variables use 99040 bytes (30%) of dynamic memory, leaving 228640 bytes for local variables. Maximum is 327680 bytes.
