zx90316/Flip-Clock/docs/bringup.md

# 從雙主控改成單主控

順序不能反：舊韌體還在用 IO13/14 當 I²C，所以要先燒新韌體，再改接線。

## 1. 先 OTA

在目前的接線下，連上時鐘網頁，用 OTA 上傳 `dist/esp32_clock/esp32_clock.ino.bin`。版本顯示 **v0.4.7** 才算完成。分割表不變，已儲存的裝置設定、密碼和 Wi-Fi 都會保留。

如果還是舊版跳出的帳號密碼視窗，帳號填 `admin`，密碼不變；更新後會改成網頁登入。

## 2. 斷電

拔掉 USB 與所有電源。

## 3. 調 LM2596

只接變壓器和 LM2596，**不接任何板子**。用電表量輸出，轉可調電阻調到 5.0V。斷電。

## 4. 改接線

拆掉 Uno、HW-209、RTC 模組，依 [wiring.md](wiring.md) 接好。馬達先脫離機構負載。

## 5. 上電檢查

- 未操作前馬達應不轉，驅動板四顆相位燈不應持續亮。
- 網頁能開，版本 v0.4.7，「目前時間」在連上 Wi-Fi 後出現。
- 如果開不了機或一直重開機，立刻斷電。先查 IO12，再查 5V 電壓。

狀態會先顯示「需要歸零」或自動恢復。**開機自動補跑時馬達會自己轉**，所以第一次上電請保持馬達脫離負載，也可以按「暫停走時」。

## 6. 測馬達

從網頁步驟 4 前進 1 分鐘，確認馬達往正確方向平順轉動。進階設定可把速度先調低（例如 300），確定正常再回到 900。

方向相反時，對調 ULN2003 的馬達線序並不適用（五線接頭固定），請告訴我，韌體要改相序方向。

## 7. 裝回機構並歸零

依 [web.md](web.md) 的歸零流程：輸入顯示的時間、視需要手動進步調整分輪角度，然後可直接儲存並開始走時。前進檢查為選做。

## 8. 長期驗收

測斷電重啟補跑、長時間走時是否漏頁，逐項填 [hardware-acceptance.csv](hardware-acceptance.csv)。
