zx90316/Flip-Clock/docs/host-tests.txt

PASS core: 23039 checks; motion, planner, calendar, NVS, BLE stream
PASS app: 209 checks; actual command/supervisor/motor/NVS/web code with simulated devices
..........
----------------------------------------------------------------------
Ran 10 tests in 0.282s

OK
PASS web UI: step plan, one-time advance, snapshot, direct save/start
