zx90316/Flip-Clock/cad/r2/RESULTS.md

# FC-R2 原型校準與 FDM 結果

2026-11-06。本輪 **PASS_SIMULATION_ONLY**：兩種時間步長的交替步進、15 次連續分鐘步進及 3 次連續小時步進，皆符合下述模擬定位門檻。實機、材料、顯示可讀性與製造定版尚未驗證。

## 本輪修正

保留 **190 × 175.4 × 120 mm** 的桌面外形、暖白圓角罩殼、深色前板及隱藏傳動。分鐘 60 片／6°、小時 24 片／15°，獨立輸出軸與定位機構，只有一個輸入馬達。這輪未讀取原作者 ZIP 的幾何、圖樣或量測尺寸。

舊棘爪止擋在接合側前 8° 掃描都沒有接觸。現在棘爪增加連通的尾端接觸面，載體止擋避開樞軸；接合側約 ±3.5° 開始接觸，空轉側掃描至 35° 無相交。兩個載體、兩個棘爪均為有效單一原生實體，見 [止擋檢查](reports/pawl_stops.json)。此處使用實體接觸，沒有以關節角度限制代替。

R2 改用 MuJoCo 原生凸體碰撞，關節摩擦時間常數為 0.0002 s、阻抗 0.999；接觸時間常數維持 0.0006 s。此設定在本輪試驗中降低了靜止摩擦的數值滑動，不代表 PETG 彈性或毛氈材料已量測。預設與失敗診斷的區分見 [設定說明](config/README.md)。

## 模擬定位驗收

主回放為 `20261106T002445_741614Z_drive`：MuJoCo 3.17.0、g=9.81 m/s²、時間步長 **0.00005 s**，296,325 個積分步、14.81625 秒物理時間。從初始狀態開始的四個指令都納入驗收，沒有丟棄第一循環。

模型為 99 個剛體、98 個自由度，包含 84 個獨立翻片鉸鏈；僅輸入軸有一個有限扭矩致動器，齒輪等式與輸出致動器均為零。積分途中沒有指定輸出輪或翻片姿態。輸入上限 50 mN·m，被動阻力提案為分鐘 5 mN·m／小時 20 mN·m；接近目標前 0.2° 放開馬達，停靠 1 秒。回授使用理想模擬編碼器。

固定門檻：分鐘終點誤差 ≤0.25°、小時 ≤0.4°；閒置輪相對最後一次命令刻度的全積分步最大偏移 ≤0.25°；最後 0.25 秒的角度範圍 ≤0.1°、平均絕對角速度 ≤1°/s；初始穿透 <0.001 mm、全步長最大穿透 ≤0.2 mm；零逾時、零求解器警告、零迭代上限事件。目標沿名義刻度累進，失步後不把目標改設在錯誤位置。

主回放四次步進都進入捕捉區，第二循環結果為：

- 分鐘目標 −12°，停在 **−12.007145°**，誤差 −0.007145°。
- 小時目標 −30°，停在 **−29.804728°**，誤差 +0.195272°。
- 四個指令的閒置輪最大偏移 **0.186255°**；此值包含小時輪上一步的終點偏差，並非只量本步淨漂移。
- 初始穿透為零，全步長最大穿透 **0.194881 mm**，峰值在分鐘定位壓輪與凸輪。沒有警告或迭代上限事件。

逐步誤差、停靠範圍及速度見 [完整驗收](review_native/validation.json)。穿透仍接近 0.2 mm 門檻，不能據此推定真實零件變形或強度成立。

相同模型、來源、控制器及參數，只把時間步長改為 **0.0001 s** 的獨立運算亦通過全部指令；最大穿透為 0.196183 mm。兩次運算第二循環的分鐘終點差約 0.000005°、小時約 0.000337°，低於 0.05° 比較門檻，見 [時間步長比較](reports/timestep_comparison.json)。這只證明本次兩種步長下的檢查一致，沒有宣稱全部接觸波形、全轉角或實機預測已收斂。

同一候選設定、0.0001 s 步長，另從初始狀態執行：

- **15 次分鐘步進**：32.3507 秒物理時間，最大定位誤差 **0.008132°**，閒置小時輪最大偏移 **0.036120°**，最大穿透 **0.190520 mm**；15 次均通過。
- **3 次小時步進**：13.5804 秒物理時間，最大定位誤差 **0.197954°**，閒置分鐘輪最大偏移 **0.008079°**，最大穿透 **0.137966 mm**；3 次均通過。

這些是連續指令測試，沒有模擬每格相隔 60 秒的實際計時，也不是全周或耐久試驗。額外測試的設定一致性及驗收已納入 [總驗收](review_native/acceptance.json)。

## 失敗紀錄與顯示界線

原生碰撞搭配舊摩擦正則化時，交替步進可以通過，15 次連續分鐘測試卻出現閒置小時輪 **0.417185°** 偏移。失敗運算完整保留於 `review_native/comparison/20261106T001941_374643Z_minute/`。更換摩擦求解設定後，才重跑並通過上述連續測試。

只有新止擋、仍用舊碰撞管線的失敗運算保留於 `review_native/comparison/20261105T081556_663338Z_drive/`，附其不同版本的完整模型。更早的失敗基準與影片在 [舊回放](review/README.md)，未被覆寫。

主回放終點，前方射線命中翻片的取樣對應第 02 片正面與第 01 片背面，圖稿值同為 02；部分射線命中固定幾何，見 [展示姿態取樣](reports/display_pose.json)。這沒有證明整個視窗字樣清楚、上下半字對齊或每次指令都確實翻片。**`flip_evidence_verified` 保持 false。** 三個角度的回放終點已作圖像檢視，沒有改寫成理想顯示姿態。

## FDM 與保存幾何

依使用者指定的 Bambu X2D、0.4 mm 噴嘴、0.2 mm 層高、PLA／PETG、256 × 256 mm 成形面設計，未連線列印機或輸出機台 G-code。

- **141 件列印零件**：原生實體有效、每件連通，指定方向 XY 尺寸均在 256 × 256 mm 內。打包時另逐件檢查全部 STL 的封閉拓撲與正體積。
- **16 個固定列印件**：28 次精確相交判定，超過 0.0001 mm³ 的重疊為零；這不是完整運動包絡檢查。
- **5 組齒輪、905 個理論嚙合姿態**：二維輪廓最大重疊為零，不能代替動態驗收。
- **61 個代表 STL**：DfAM 工具各取 2,000 點，全部封閉、量測完整、壁厚 P05 ≥1.2 mm。其餘 80 件為相同空白翻片的編號變體。四個改動零件已重新量測，棘爪 P05 1.4 mm、載體 2.4 mm。

翻片保留 **1.2 mm 六層完整片體**，前面貼床、轉軸削平；自繪七段字樣採雙面轉印／上色，STL 無凸字或凹槽。相較 R1，翻片壁厚 P05 由 0.85 改為 1.2 mm，45° 門檻下需支撐面積由 1,330.94 降至 **5.45 mm²**。此比較包含尺寸、造型與方向的共同改變，小轉軸仍需局部支撐。

壁厚依 text-to-cad 0.7.17 dfam-check 的支撐壁厚 1.2 mm 判斷，懸空壁另需 1.6 mm。孔口、軸肩及固定耳仍有支撐／橋接試印需求。最小值、P05、非零支撐面積及替代方向在 [DfAM 報告](reports/dfam/summary.json)。小孔、最小凸出特徵、橋距、切片連續性、縮率與磨耗未被工具完整驗證，不能以壁厚結果替代。

[交付一致性檢查](reports/delivery_consistency.json) 已核對報告與目前精確 CAD／STL 雜湊，沒有沿用改動前的網格量測。罩殼倒置、前後板平放、機構寬面貼床的方向維持不變。

## 實物阻力與試片

兩個非列印毛氈環為外徑 20 mm、內徑 16.2 mm、安裝厚度 1.1 mm，置於軸承外側與旋鈕間。保存 STEP 中與相鄰零件的名義相交體積皆為零，見 [間隙與力目標](reports/drag_fit.json)。

假設摩擦係數 0.2、均勻接觸壓力，分鐘／小時法向力提案約 **2.75／11.01 N**。自由厚度 1.5 mm 不保證預壓成立。先抬起定位壓輪，在半徑 13 mm 旋鈕量切向阻力，目標約 **0.385／1.538 N**，再調環厚與預壓。毛氈壓縮、軸承軸向負荷、磨耗與黏著未驗證。

定位彈簧提案為分鐘 337 N/m、小時 500 N/m、初壓 1 mm。50 mN·m 僅為輸入扭矩預算，未確認為特定 28BYJ-48 的能力；馬達、皮帶與感測板採購尺寸仍待核對。

先列印薄片與配合試片，PLA、PETG 分別量孔徑、間隙與片重。試片以未旋轉 STL 的 +Z 俯視判讀：Y=0 小孔沿 +X 為 Ø2.4／2.5／2.6／2.7 mm；Y=25 mm 大孔沿 +X 為 Ø8.0／8.1／8.2／8.3 mm。先用 M08、M09 確認雙面方向及上下半字，再處理全組 84 片。

## 交付與限制

[原型 ZIP](package/FC-R2-desktop-prototype.zip) 包含五個 STEP 裝配／檢視模型、141 件 STEP／STL、配合試片、向量圖稿、參數與來源。從解出的來源與共用函式重建候選裝配後，保存 STEP 的 **1,056 個葉節點**標籤順序一致、總體積差為零，見 [重建紀錄](reports/package_rebuild.json)。最終打包再核對模型來源、全部檔案雜湊與 ZIP CRC。

[本輪回放](review_native/README.md) 含三支影片、890 個實際狀態取樣、終止狀態、接觸紀錄、可攜式模型與執行來源。影片由 60 Hz 狀態慢放至 30 fps，含實際終止取樣；每支 914 影格，沒有補造成功姿態。[證據完整性檢查](reports/review_native_audit.json) 已核對 159 個檔案雜湊並完整解碼三支影片，與物理驗收分開。

底座固定於世界座標，未測整機滑移或傾倒。齒輪與軸同體連接假設剛性傳力，實物固定方式仍待驗證。質量來自完整 CAD 與提案密度，未秤重；未模擬皮帶彈性、跳齒、馬達相位、齒輪箱間隙、薄片彎曲、層間強度、孔磨耗、感測誤差或電子延遲。軸承／銷以鉸鏈等效，碰撞輪廓填平非工作孔。

**`hardware_verified`、`manufacturing_ready`、`physics_predictive_validation` 全部維持 false。** 當前交付可檢視、可重建、可供試片；仍需顯示與實物校準後才能凍結整機製造。
