zx90316/Flip-Clock/(commit log)

2026-10-31 Initial import: ESP32-CAM + Uno split-flap clock
    Dual-controller firmware, protocol library, host tests, VS Code tasks,
    BLE tools, and bring-up docs. Uno 0.2.0 flashed and single-motor bench verified.
    [hardware-acceptance.csv, partitions.csv]
2026-10-31 Record ESP32-CAM first flash and bring-up notes
    Add --skip-build option to build.py upload.
    [build.py]
2026-10-31 Add web commissioning console and power-cycle position restore (ESP 0.3.0)
    Soft-AP web UI: phone time sync, manual zero, multi-target trial runs with
    calibration helper, finish and auto-run. Persist position when caught up,
    restore from the snapshot on boot and catch up to the RTC automatically.
2026-10-31 Add web OTA update and switch ESP32 to the dual-OTA min_spiffs partition table
    OTA is accepted only while the motor is idle and disarmed; failed or
    interrupted uploads keep the running image. NVS offset is unchanged so
    settings and the web password survive the one-time UART reflash.
    [partitions.csv]
2026-10-31 Support PCF8563 RTC modules (HW-689) alongside DS3231
    Probe 0x68 then 0x51 and normalise the PCF8563 registers to the DS3231
    layout. The user's RTC module turned out to be a PCF8563.
2026-10-31 Add Wi-Fi provisioning, high-speed zeroing and a pause-during-save fix
    Wi-Fi: scan, trial-connect, save only after a verified connection, restore on
    failure. Speed: limits raised to 1000 steps/s and 4000 steps/s^2, multi-page
    moves merged into one continuous ramped move, move timeout margin. NTP: small
    corrections no longer stop a running clock. Fix: a pause pressed during a
    background position save was reverted when the save finished.
    [FlipPlan.h, FlipProtocol.h, app.cpp, build.py, release_manifest.py, test_app.cpp, test_core.cpp]
2026-11-01 Retry failed Wi-Fi scans, show LAN address and flipclock.local after connecting
    [app.cpp, test_app.cpp]
2026-11-01 Switch to a single ESP32-CAM controller: drive the ULN2003 directly, remove the Uno and its I2C protocol
    [hardware-acceptance.csv]
2026-11-01 Fix remaining Uno wording in the page, comment and library description
    [app.cpp]
2026-11-01 Report why Wi-Fi fails, retry within the trial and pause BLE advertising during it
    [app.cpp, build.py, release_manifest.py, test_app.cpp]
2026-11-03 Release Flip Clock v0.4.7 with step planning and stable Wi-Fi setup
    [app.cpp, build.py, package.py, release_manifest.py, run.py, test_app.cpp]
2026-11-04 Add FC-R1 CAD and gravity-contact physics review
    Build a new parametric single-motor dual-ratchet clock with 24/60 flap drums.
    Include a warning-free MuJoCo 3.17 run, portable replay assets, recorded
    contacts and three slow-motion videos with gravity and timestep comparisons.
    Exclude original author payloads and local compilation caches. Document
    uncalibrated parameters, output coasting and pending manual viewer checks.
    [arm_H_ivory_2.stl, arm_H_steel_2.stl, arm_M_ivory_2.stl, arm_M_steel_2.stl, bom.csv, drum_H_H_2.stl, drum_H_ivory_2.stl, drum_H_steel_2.stl]
2026-11-05 feat(cad): add R2 desktop FDM prototype and calibration evidence
    Add compact 190 mm desktop enclosure, 1.2 mm flaps, printable part catalog, fit coupons and prototype archive. Preserve failed fine-timestep physics replay and controlled comparisons; hardware and manufacturing acceptance remain unverified.
    [E_motor_top_clamp.json, E_motor_top_clamp_orientations.json, E_slotted_motor_saddle.json, E_slotted_motor_saddle_orientations.json, arm_H_0.stl, arm_M_0.stl, drum_H_0.stl, drum_M_0.stl]
2026-11-06 fix(cad): calibrate R2 pawl stops and native contact motion
    Add working pawl heel stops and retain the compact desktop FDM geometry.
    Use native collision with explicit friction regularization and nominal targets.
    Validate both time steps, 15 minute commands and 3 hour commands; preserve failed trials.
    Publish recorded physics videos and rebuild the 141-part prototype package.
    Keep hardware, manufacturing and display flip evidence unverified.
    [arm_H_0.stl, arm_M_0.stl, drum_H_0.stl, drum_M_0.stl, flap_blank.stl, h_idler_0_0.stl, h_idler_1_0.stl, idler_0.stl]
